kuka-kr16-l6/Motion-control-solutions-for-an-industrial-manipulator/GUI/UntitledProject1Content/images/images3.jpg

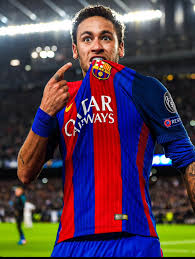
GUI/UntitledProject1Content/images/images3.jpg
