kuka-kr16-l6/Motion-control-solutions-for-an-industrial-manipulator/GUI/UntitledProject1Content/images/images.jpg

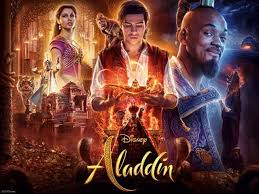
GUI/UntitledProject1Content/images/images.jpg
