kuka-kr16-l6/Motion-control-solutions-for-an-industrial-manipulator/hardware/control_cabinet/Kuka Robot Arm Panel.edb/Images/bc146770/EPLAN.jpg

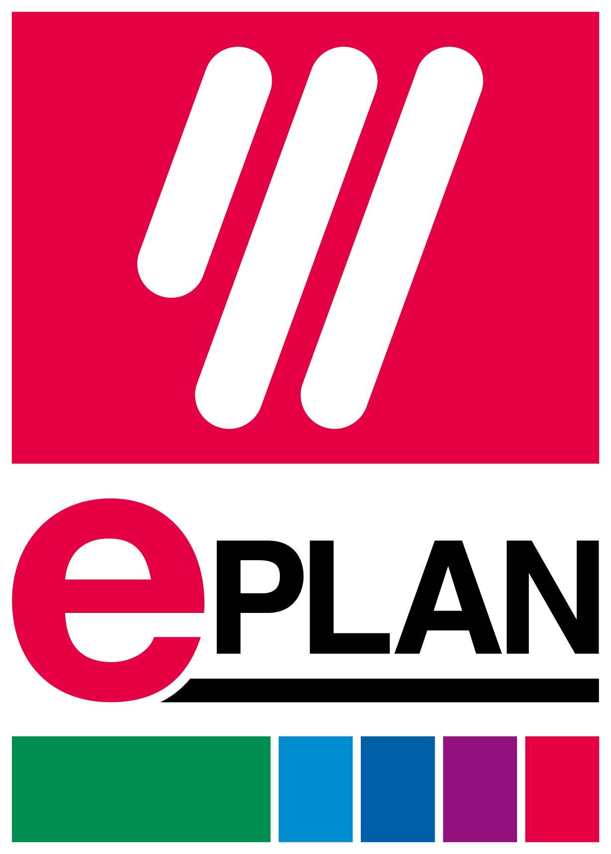
hardware/control_cabinet/Kuka Robot Arm Panel.edb/Images/bc146770/EPLAN.jpg
