kuka-kr16-l6/Motion-control-solutions-for-an-industrial-manipulator/hardware/control_cabinet/Kuka Robot Arm Panel.edb/Images/M54d7e7ba/WhatsApp Image 2026-07-18 at 9.05.26 AM.jpeg

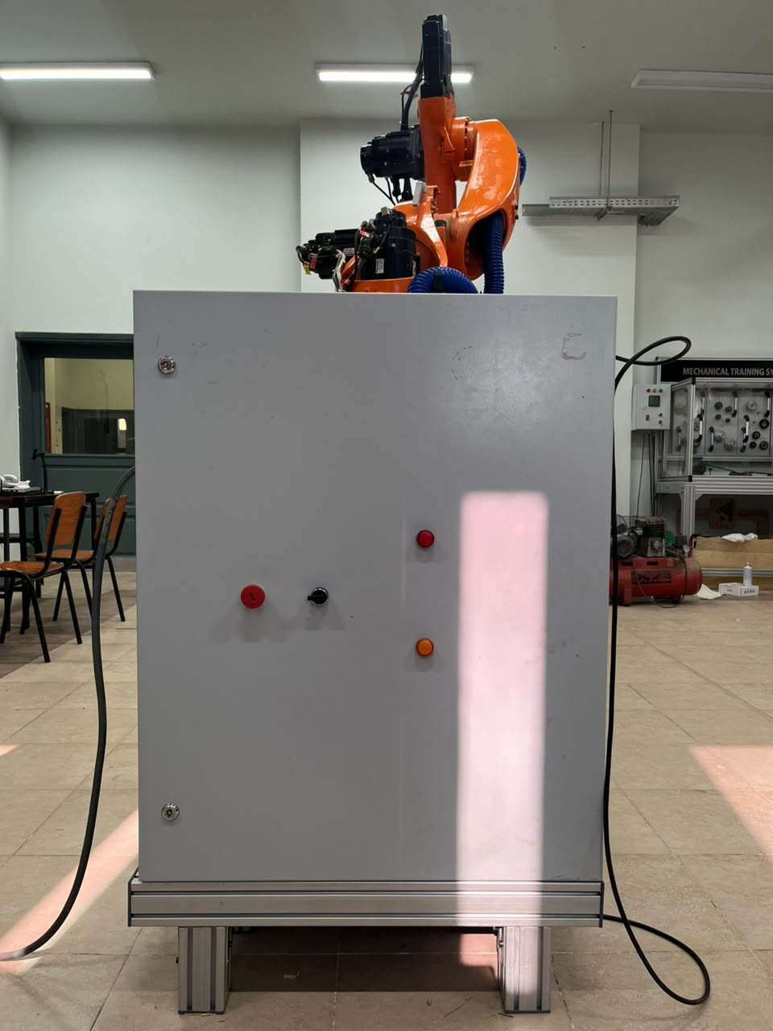
hardware/control_cabinet/Kuka Robot Arm Panel.edb/Images/M54d7e7ba/WhatsApp Image 2026-07-18 at 9.05.26 AM.jpeg
