kuka-kr16-l6/Motion-control-solutions-for-an-industrial-manipulator/hardware/control_cabinet/Kuka Robot Arm Panel.edb/Images/M33027262/WhatsApp Image 2026-08-03 at 3.58.57 PM (1).jpeg

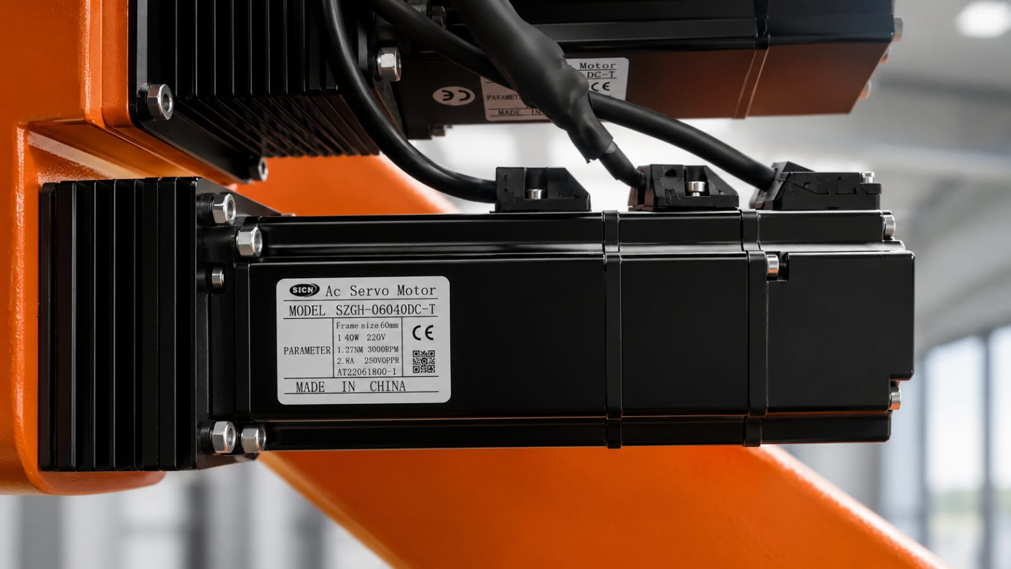
hardware/control_cabinet/Kuka Robot Arm Panel.edb/Images/M33027262/WhatsApp Image 2026-08-03 at 3.58.57 PM (1).jpeg
