kuka-kr16-l6/Motion-control-solutions-for-an-industrial-manipulator/hardware/mechanical/solidworks_assembly/kr16_l6/KR16-AV300.sldasm-Part-1-1.SLDPRT

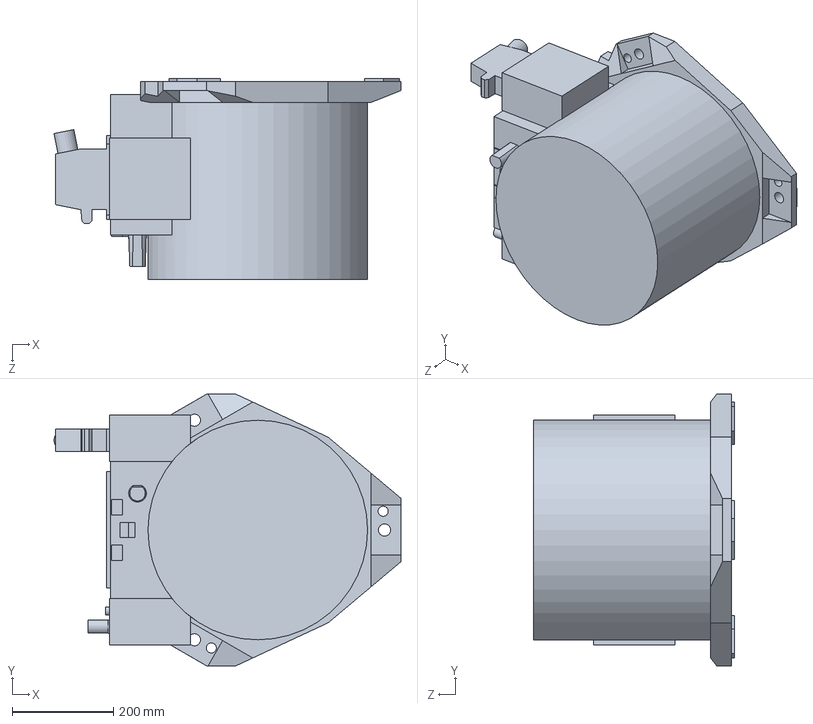
[picture p20: CAD file, 2026-01-29]
hardware/mechanical/solidworks_assembly/kr16_l6/KR16-AV300.sldasm-Part-1-1.SLDPRT
684.3 x 536.0 x 396.9 mm
