kuka-kr16-l6/Motion-control-solutions-for-an-industrial-manipulator/hardware/mechanical/solidworks_assembly/kr16_l6/KR16-AV300.sldasm-Part-16.SLDPRT

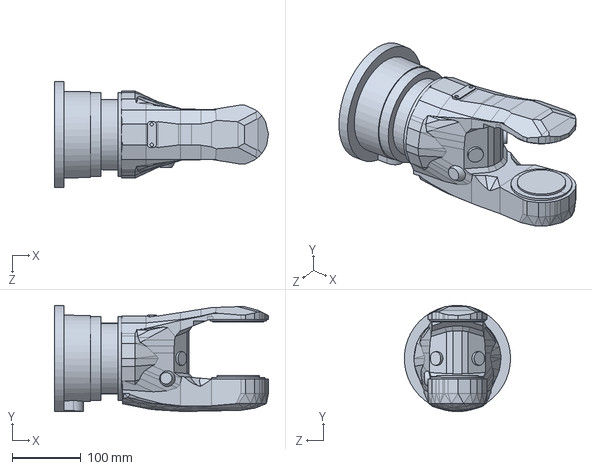
[picture p21: CAD file, 2026-01-29]
hardware/mechanical/solidworks_assembly/kr16_l6/KR16-AV300.sldasm-Part-16.SLDPRT
312.2 x 155.0 x 154.8 mm
