kuka-kr16-l6/Motion-control-solutions-for-an-industrial-manipulator/hardware/mechanical/solidworks_assembly/kr16_l6/KR16-AV300.sldasm-Part-7.SLDPRT

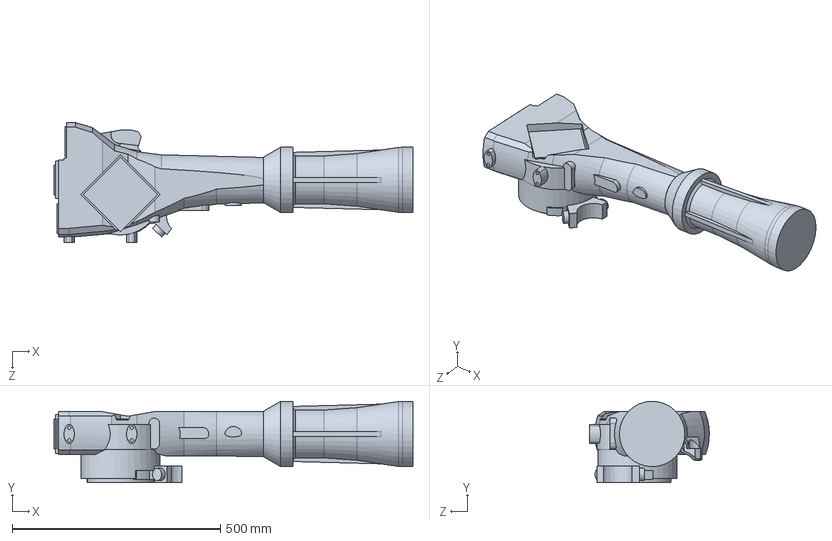
[picture p22: CAD file, 2026-01-29]
hardware/mechanical/solidworks_assembly/kr16_l6/KR16-AV300.sldasm-Part-7.SLDPRT
861.5 x 195.5 x 287.5 mm
