kuka-kr16-l6/Motion-control-solutions-for-an-industrial-manipulator/hardware/mechanical/solidworks_assembly/kr16_l6/KR16-AV300.sldasm-Part-15.SLDPRT

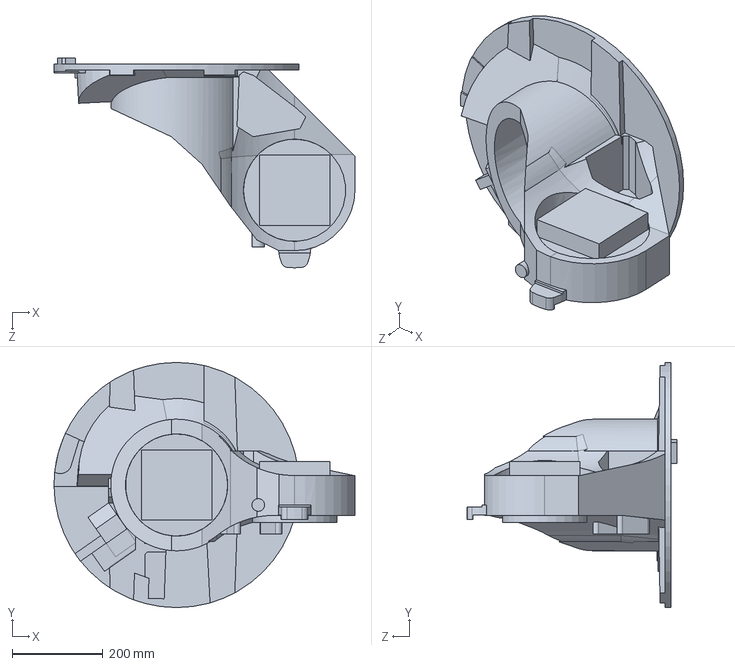
[picture p23: CAD file, 2026-01-29]
hardware/mechanical/solidworks_assembly/kr16_l6/KR16-AV300.sldasm-Part-15.SLDPRT
663.0 x 540.0 x 461.9 mm
