kuka-kr16-l6/Motion-control-solutions-for-an-industrial-manipulator/hardware/mechanical/solidworks_assembly/kr16_l6/KR16-AV300.sldasm-Part-14.SLDPRT

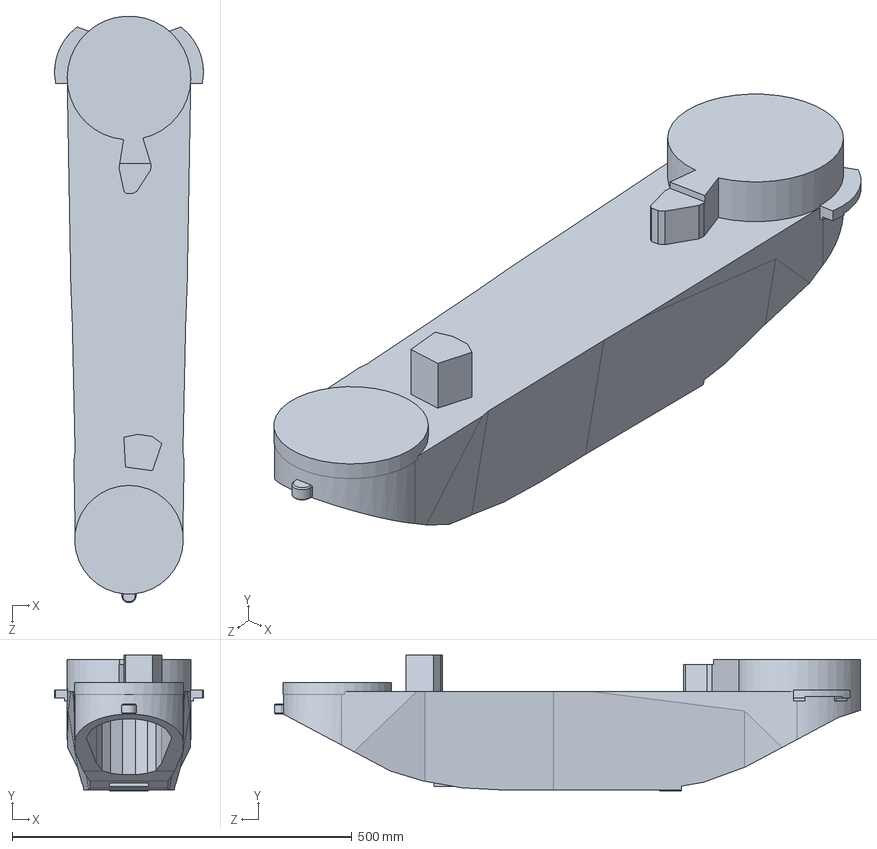
[picture p24: CAD file, 2026-01-29]
hardware/mechanical/solidworks_assembly/kr16_l6/KR16-AV300.sldasm-Part-14.SLDPRT
219.4 x 199.5 x 863.5 mm
