kuka-kr16-l6/Motion-control-solutions-for-an-industrial-manipulator/simulation_pkg/kr16_l6/meshes/collision/link_3.STL

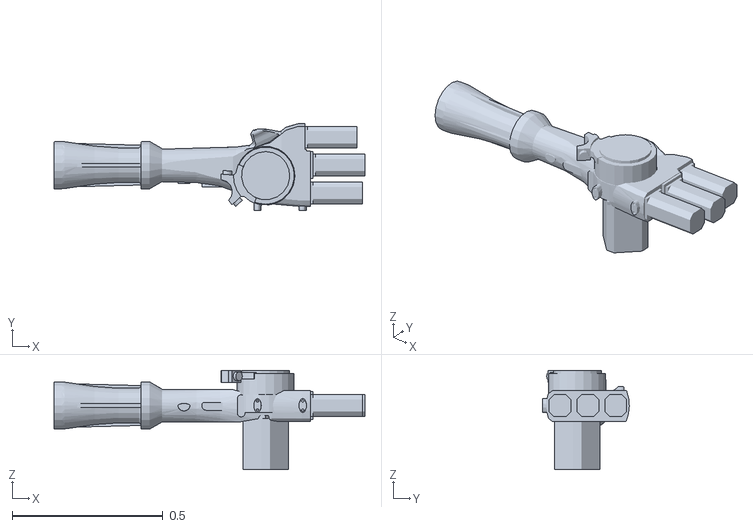
[picture p25: CAD file, 2026-01-29]
simulation_pkg/kr16_l6/meshes/collision/link_3.STL
1.03 x 0.287 x 0.33
