kuka-kr16-l6/Motion-control-solutions-for-an-industrial-manipulator/simulation_pkg/kr16_l6/meshes/visual/link_4.STL

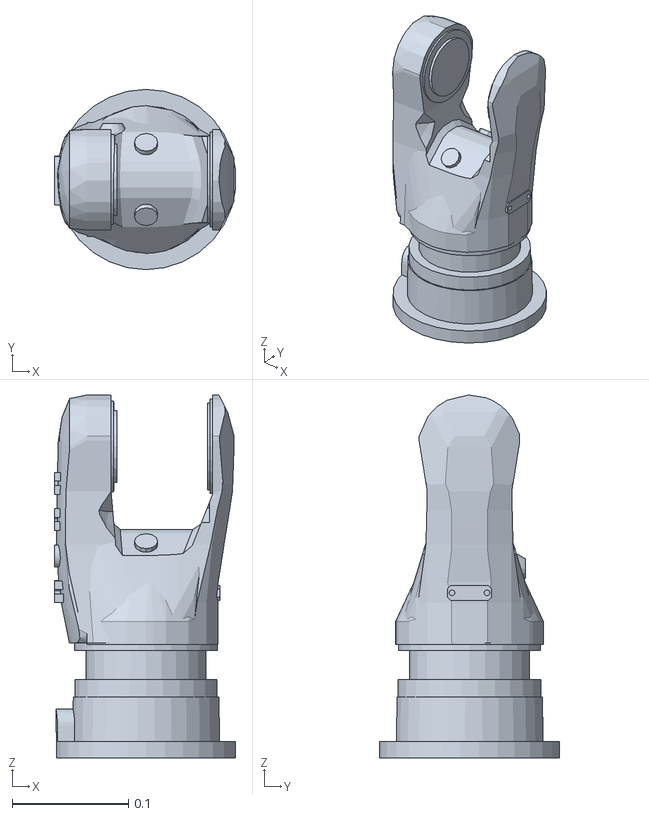
[picture p26: CAD file, 2026-01-29]
simulation_pkg/kr16_l6/meshes/visual/link_4.STL
0.156 x 0.155 x 0.312
