kuka-kr16-l6/Motion-control-solutions-for-an-industrial-manipulator/simulation_pkg/kr16_l6/meshes/collision/link_6.STL

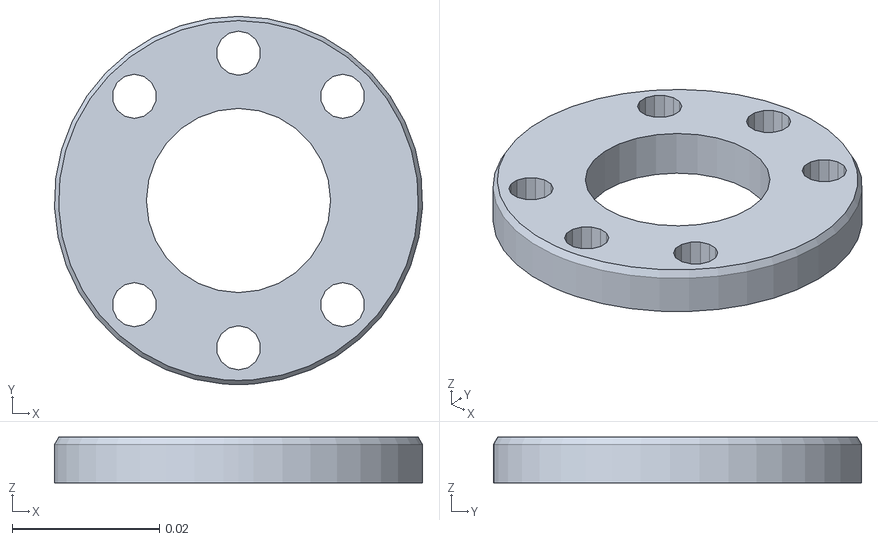
[picture p27: CAD file, 2026-01-29]
simulation_pkg/kr16_l6/meshes/collision/link_6.STL
0.05 x 0.05 x 0.0062
