kuka-kr16-l6/Motion-control-solutions-for-an-industrial-manipulator/simulation_pkg/kr16_l6/meshes/collision/link_2.STL

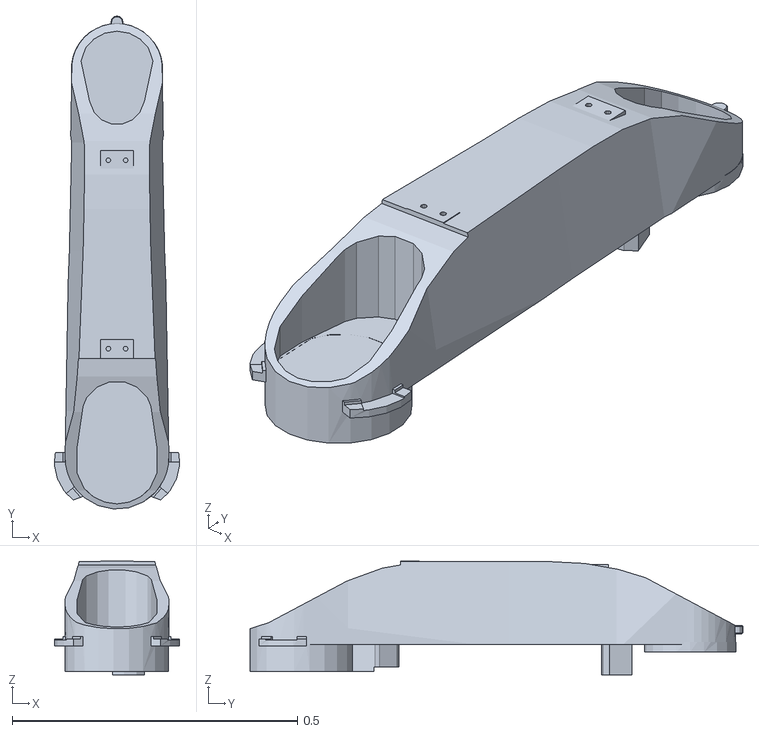
[picture p28: CAD file, 2026-01-29]
simulation_pkg/kr16_l6/meshes/collision/link_2.STL
0.219 x 0.863 x 0.199
