kuka-kr16-l6/Motion-control-solutions-for-an-industrial-manipulator/simulation_pkg/kr16_l6/meshes/visual/base_link.STL

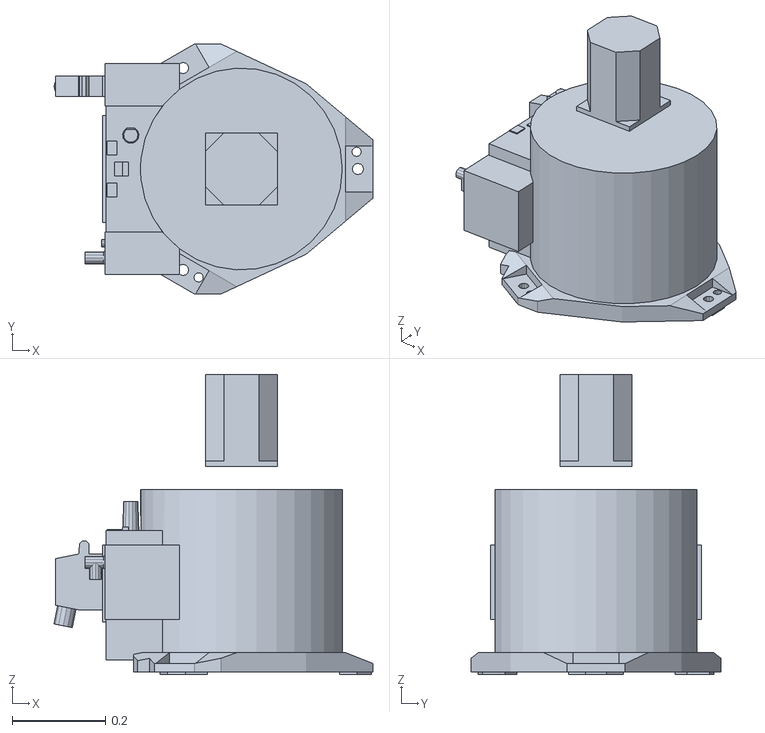
[picture p29: CAD file, 2026-01-29]
simulation_pkg/kr16_l6/meshes/visual/base_link.STL
0.684 x 0.536 x 0.644
