kuka-kr16-l6/Motion-control-solutions-for-an-industrial-manipulator/simulation_pkg/kr16_l6/meshes/visual/link_1.STL

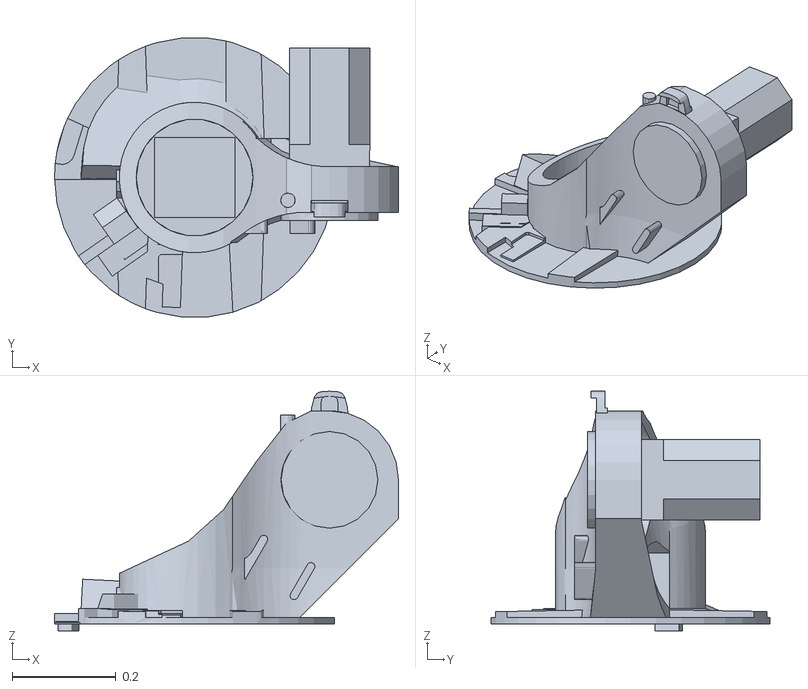
[picture p30: CAD file, 2026-01-29]
simulation_pkg/kr16_l6/meshes/visual/link_1.STL
0.663 x 0.538 x 0.462
