kuka-kr16-l6/Motion-control-solutions-for-an-industrial-manipulator/simulation_pkg/kr16_l6/meshes/collision/link_5.STL

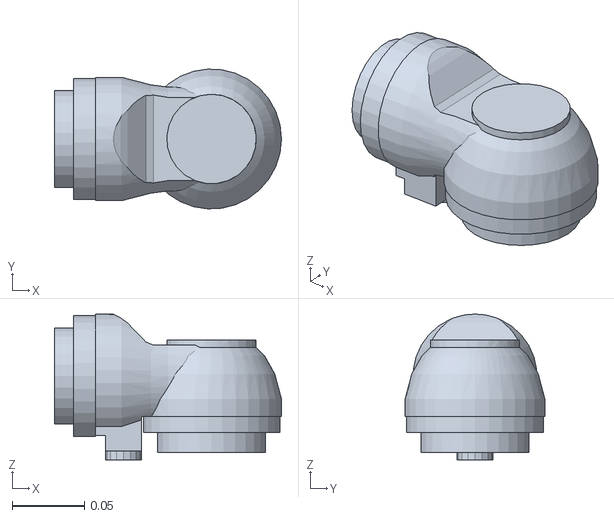
[picture p31: CAD file, 2026-01-29]
simulation_pkg/kr16_l6/meshes/collision/link_5.STL
0.157 x 0.0969 x 0.101
