kuka-kr16-l6/Motion-control-solutions-for-an-industrial-manipulator/hardware/mechanical/solidworks_assembly/kr16_l6/KR16.SLDASM

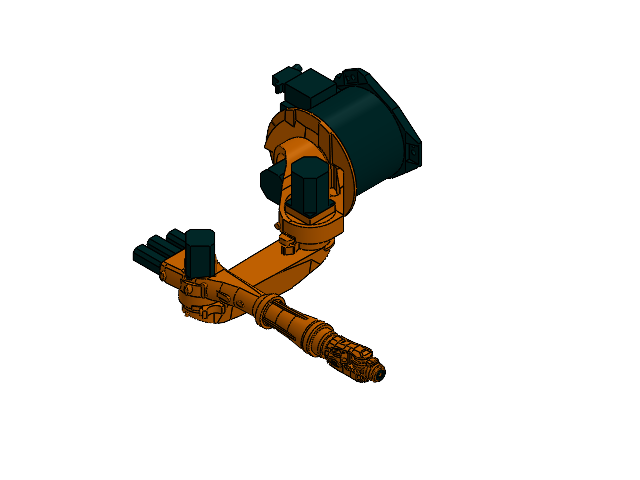
[picture p32: CAD file, 2026-01-29]
hardware/mechanical/solidworks_assembly/kr16_l6/KR16.SLDASM
KR16-AV300.sldasm-Part-1-1
KR16-AV300.sldasm-Part-2-1
KR16-AV300.sldasm-Part-3-1
KR16-AV300.sldasm-Part-4-1
KR16-AV300.sldasm-Part-5-1
KR16-AV300.sldasm-Part-6-1
KR16-AV300.sldasm-Part-7-1
KR16-AV300.sldasm-Part-8-1
KR16-AV300.sldasm-Part-9-1
KR16-AV300.sldasm-Part-10-1
KR16-AV300.sldasm-Part-11-1
KR16-AV300.sldasm-Part-12-1
KR16-AV300.sldasm-Part-13-1
KR16-AV300.sldasm-Part-14-1
KR16-AV300.sldasm-Part-15-1
KR16-AV300.sldasm-Part-16-1
KR16-AV300.sldasm-Part-17-1
