kuka-kr16-l6/Motion-control-solutions-for-an-industrial-manipulator/data/wiring&schematics.pdf

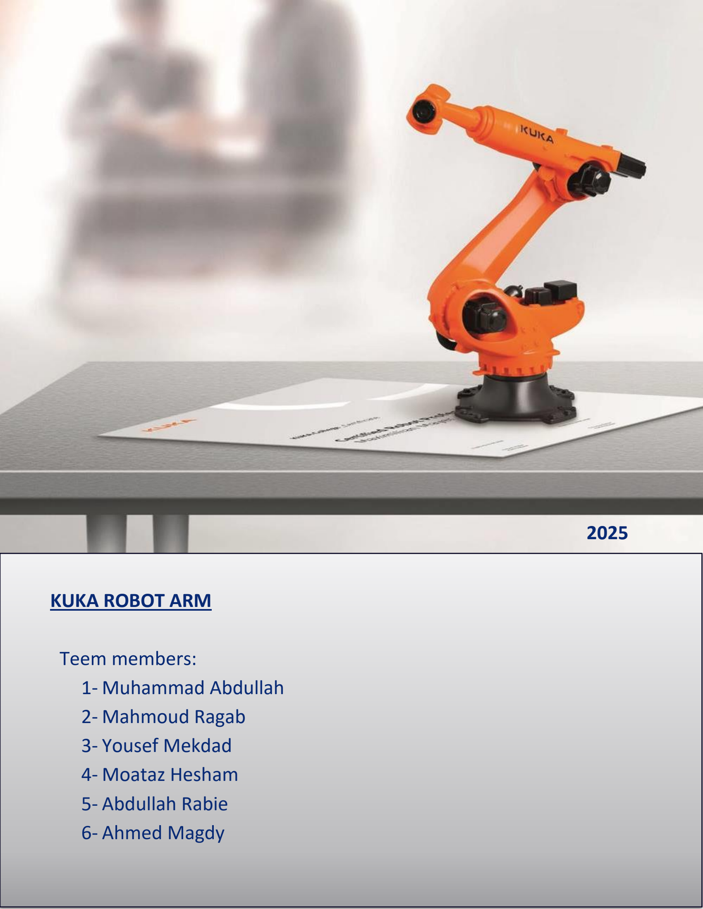
[picture p33: page 1]

1

KUKA ROBOT ARM

Teem members:
1- Muhammad Abdullah
2- Mahmoud Ragab
3- Yousef Mekdad
4- Moataz Hesham
5- Abdullah Rabie
6- Ahmed Magdy

2025

2

## ❖ Robot arm:

## ❖ Motors:

A1:

A2:

A3:

A4:

A5:

A6:

## ❖ Drivers:

A1:

A2:

A3:

A4:

A5:

A6:

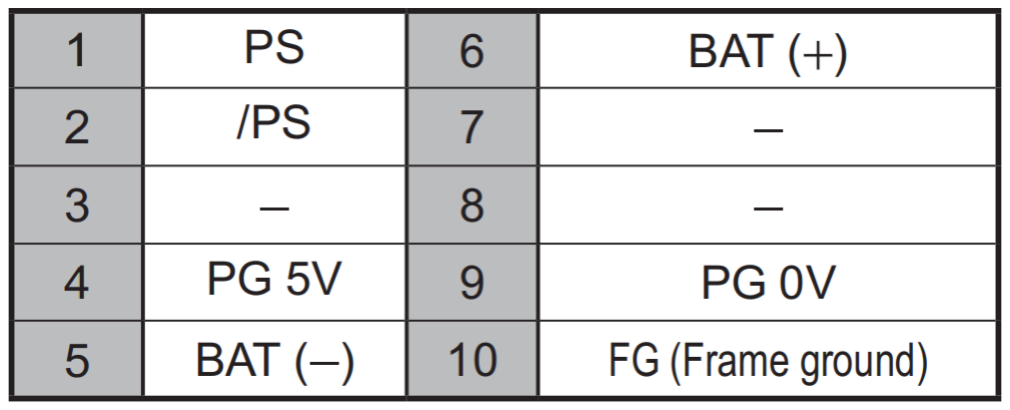
[picture p34: figure]
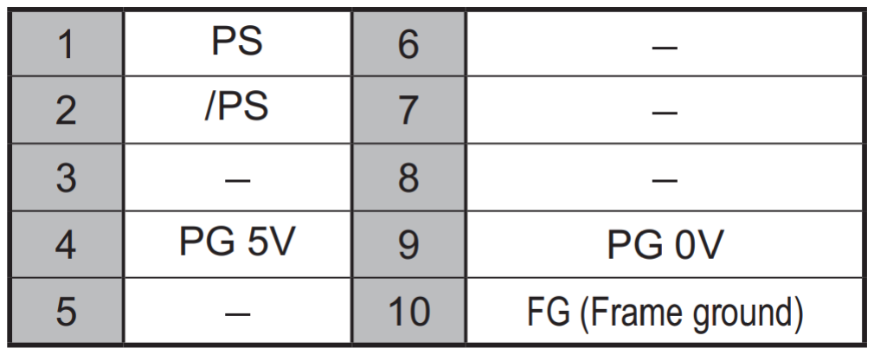
[picture p35: figure]

3

## - Motors wiring:

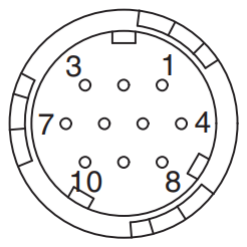
[picture p36: figure]

1-Cable Specifications for Encoder end Connector (20-bit Encoder):

- Receptacle: CM10-R10P-D.
- Plug: CM10-AP10S-¡-D (Angle) CM10SP10S-¡-D (Straight).
- Manufacturer: DDK Ltd.
- With an Absolute Encoder:
- With an Incremental Encoder:

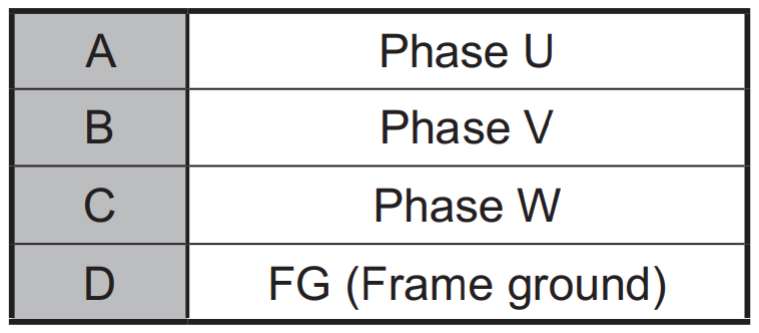
[picture p37: figure]
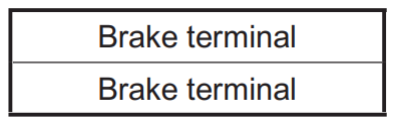
[picture p38: figure]

4

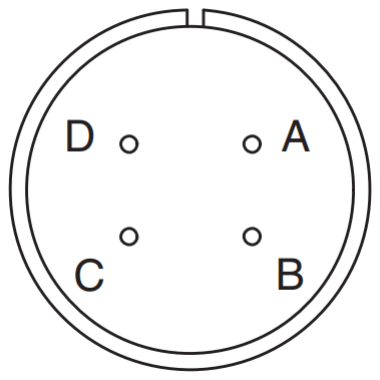
[picture p39: figure]

2- Cable Specifications for Servomotor-end Connector:

3- Cable Specifications for Brake-end Connector:

- Receptacle: CM10-R2P-D.
- Plug: CM10-AP2S-¡-D (Angle)
CM10-SP2S-¡-D (Straight).
- Manufacturer: DDK Ltd.

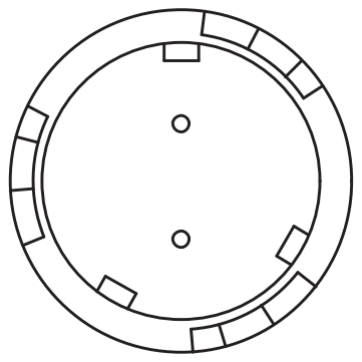
[picture p40: figure]

Note: No polarity for connection to the brake terminals.

Breaks work on 24V DC.

Make sure all shields are connected.

## - Control panel:

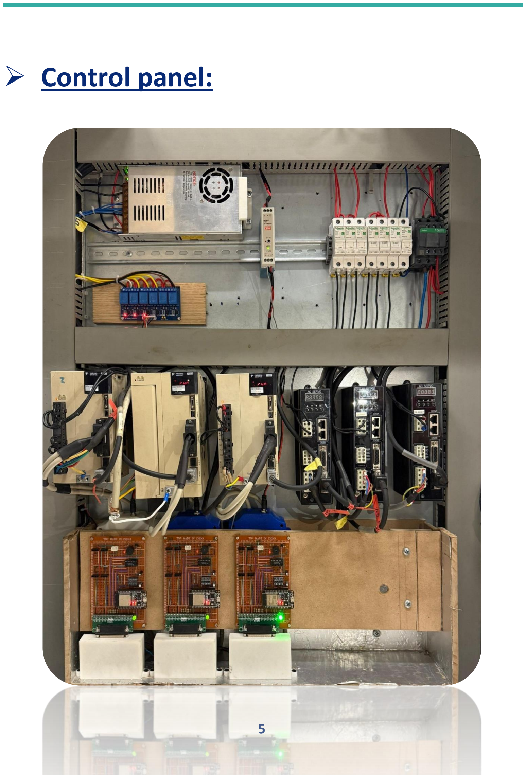
[picture p41: page 5]

5

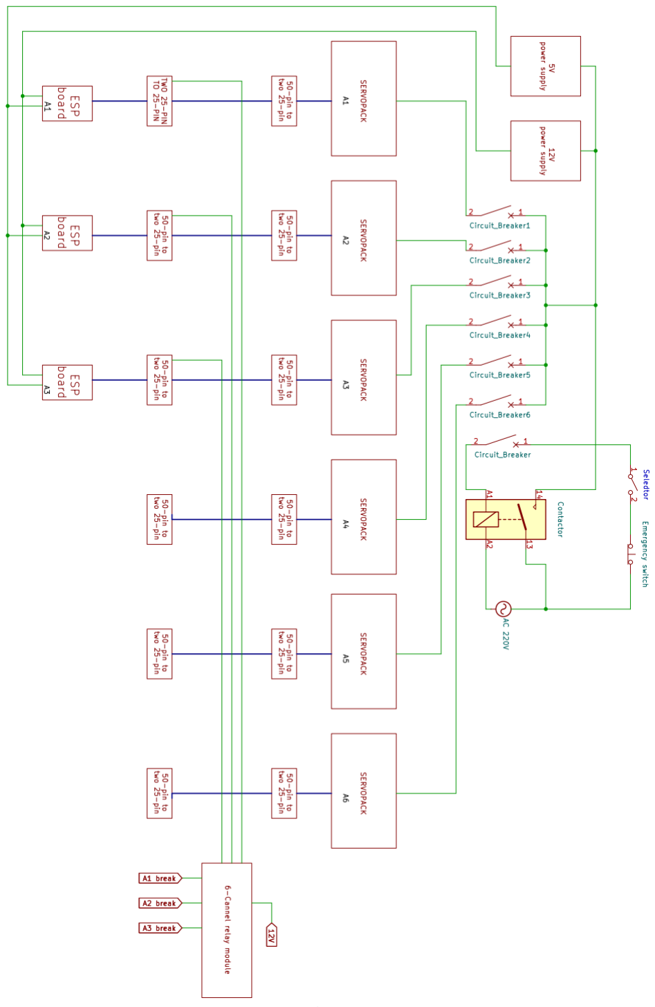
[picture p42: figure]

6

### - Panel schematic:

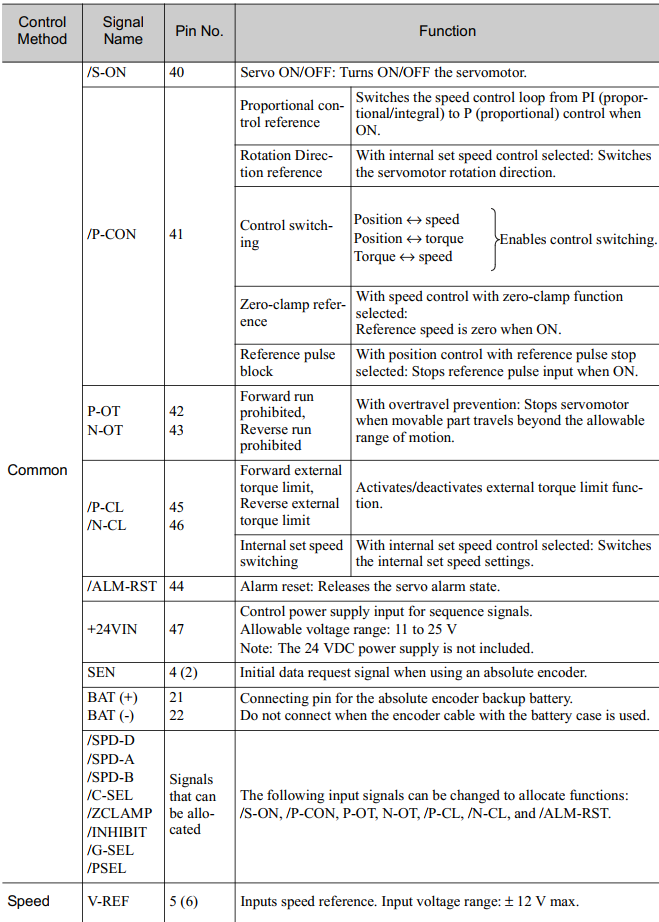
[picture p43: figure]

7

### Driver I/O Signal:

### 1-Input signals:

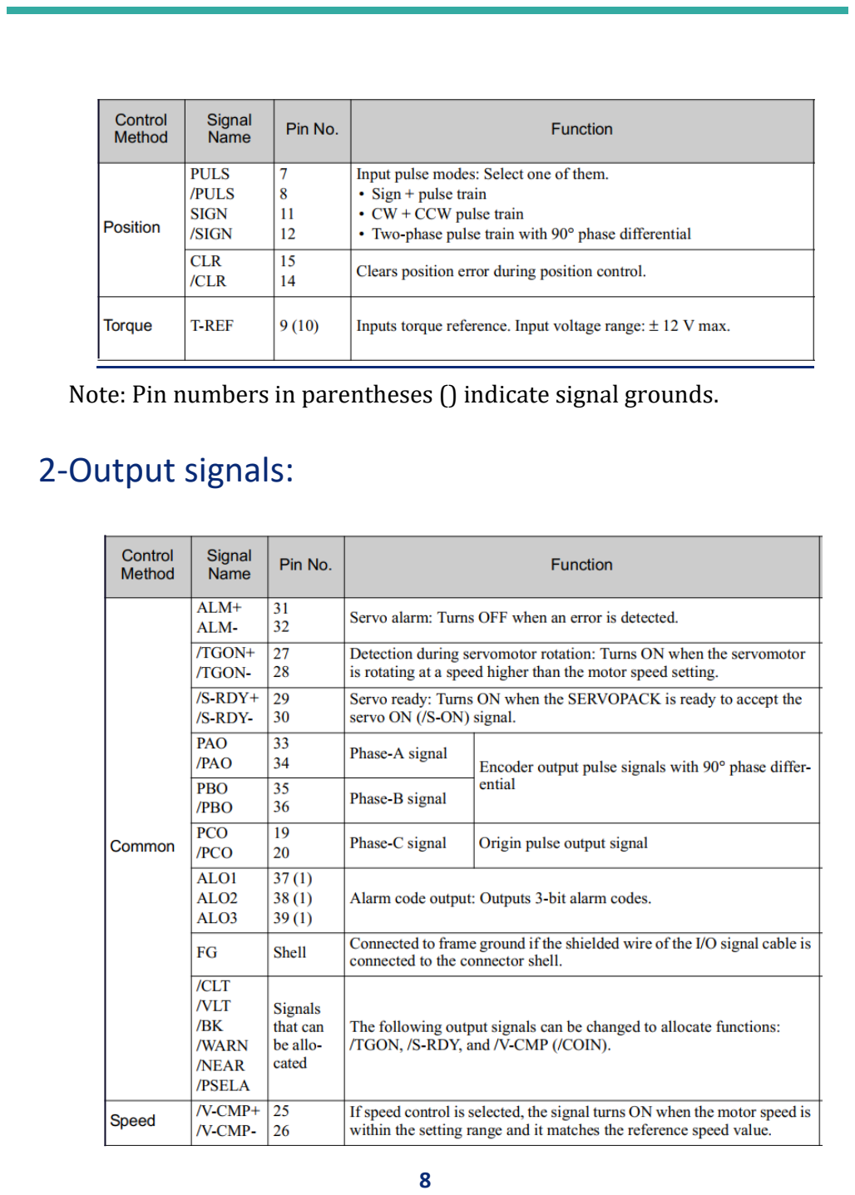
[picture p44: page 8]

8

Note: Pin numbers in parentheses () indicate signal grounds.

### 2-Output signals:

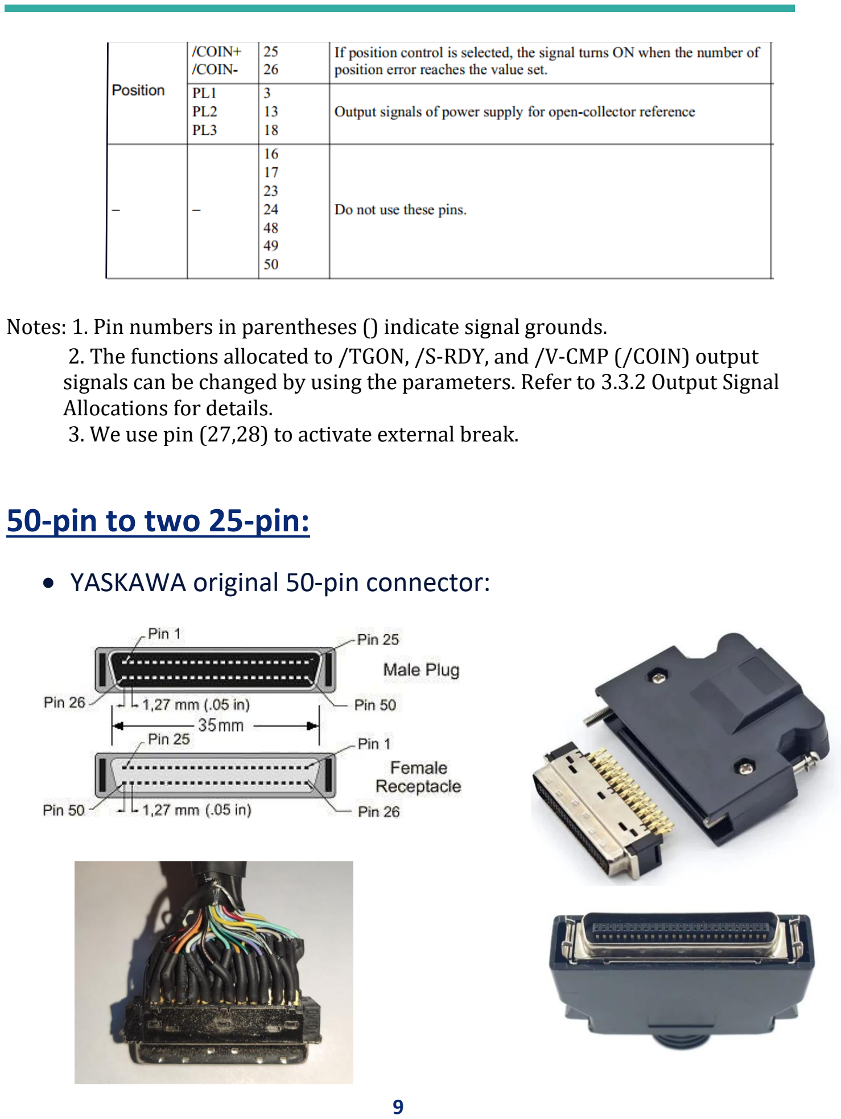
[picture p45: page 9]

9

Notes: 1. Pin numbers in parentheses () indicate signal grounds.
2. The functions allocated to /TGON, /S-RDY, and /V-CMP (/COIN) output signals can be changed by using the parameters. Refer to 3.3.2 Output Signal Allocations for details.
3. We use pin (27,28) to activate external break.

### 50-pin to two 25-pin:

- YASKAWA original 50-pin connector:

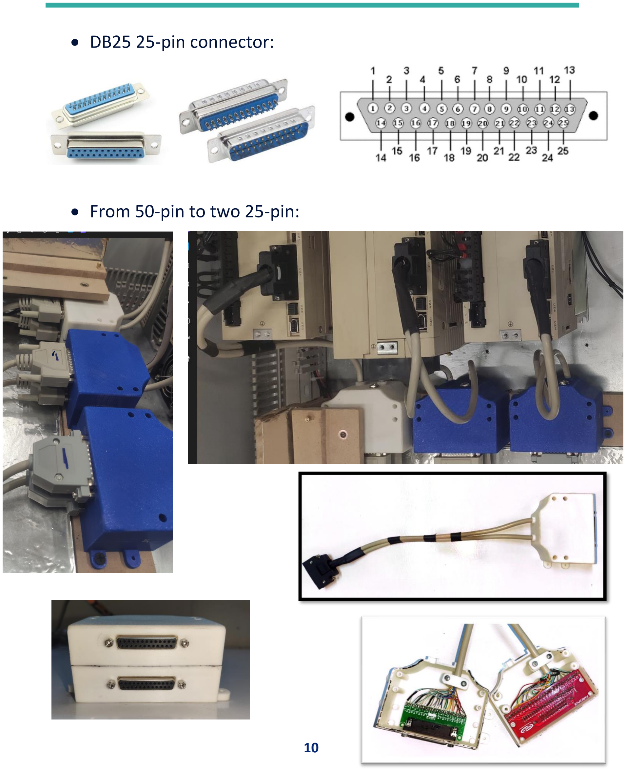
[picture p46: page 10]

10

- DB25 25-pin connector:
- From 50-pin to two 25-pin:

‘

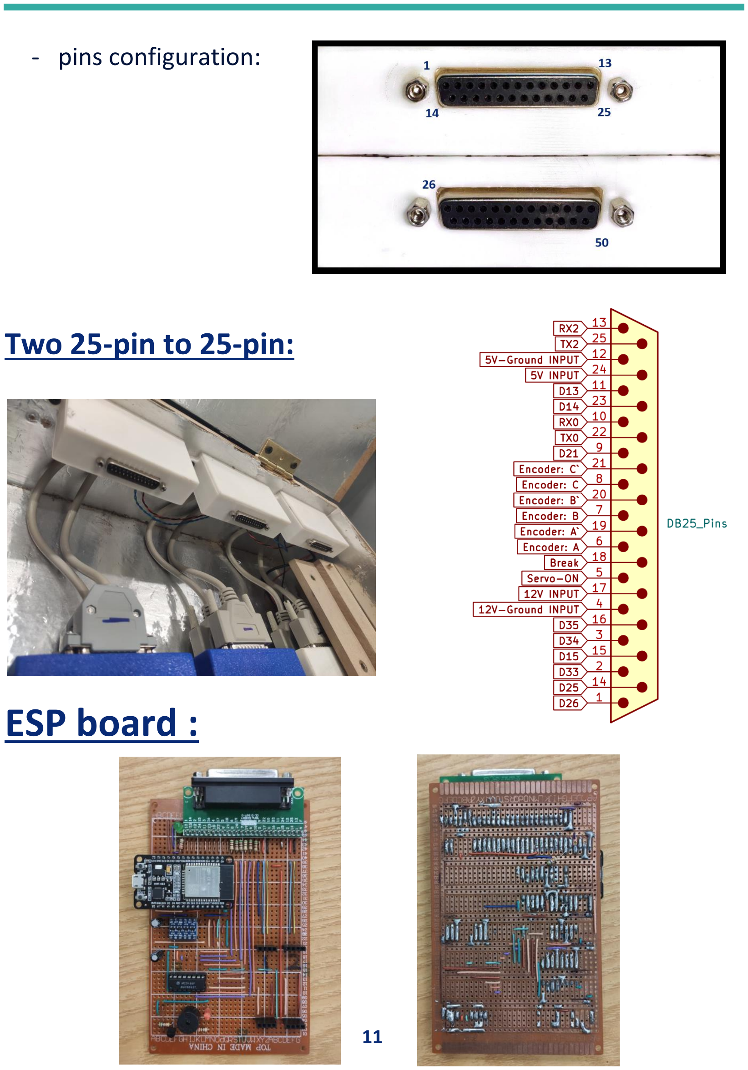
[picture p47: page 11]

11

- pins configuration:

### Two 25-pin to 25-pin:

## ESP board :

12

### I/O TABLE

ESP | DB25 connector | Function
13 | 11 (Directly connected to ESP) | Pulses
14 | 23 (Directly connected to ESP) | Sign
21 | 9 (Directly connected to ESP) | CLR
25 | 14 (Directly connected to ESP) | TRef
26 1 (Directly connected to ESP)
32 15 (Directly connected to ESP)
33 2 (Directly connected to ESP)
34 | 3 | Limit switch
35 | 16 | Limit switch
27 | 5 (servo-on) | Servo-on, Break-off (active
high) 18 (break)
19 (A) | 6 | Encoder: (Non-inverted_A)
| 19 Encoder: (Inverted_A)
18 (B) | 7 | Encoder: (Non-inverted_B)
| 20 Encoder: (Inverted_B)
4 (C) | 8 | Encoder: (Non-inverted_C)
| 21 Encoder: (Inverted_C)
23 Buzzer
RX2-TX2 | 13 RS-485 Transmitter (A)
| 25 RS-485 Transmitter (B)
RX0-TX0 | 10 RS-485 Receiver (A)
| 22 RS-485 Receiver (B)
| 24 5V INPUT
| 12 5V-Ground INPUT
| 17 12V INPUT
| 4 12V-Ground INPUT
| Shell | 5V-Ground

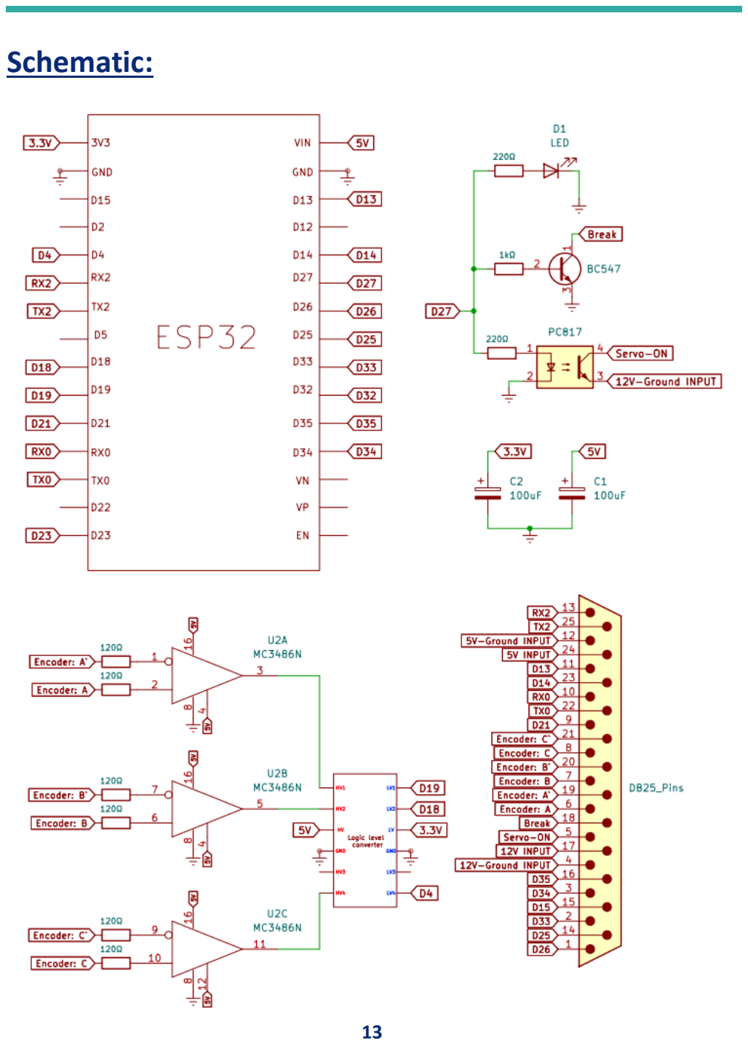
[picture p48: page 13]

13

### Schematic:

14
