kuka-kr16-l6/Motion-control-solutions-for-an-industrial-manipulator/hardware/control_cabinet/Eplan_Panel.pdf

## Faculty of Engineering

## Phone

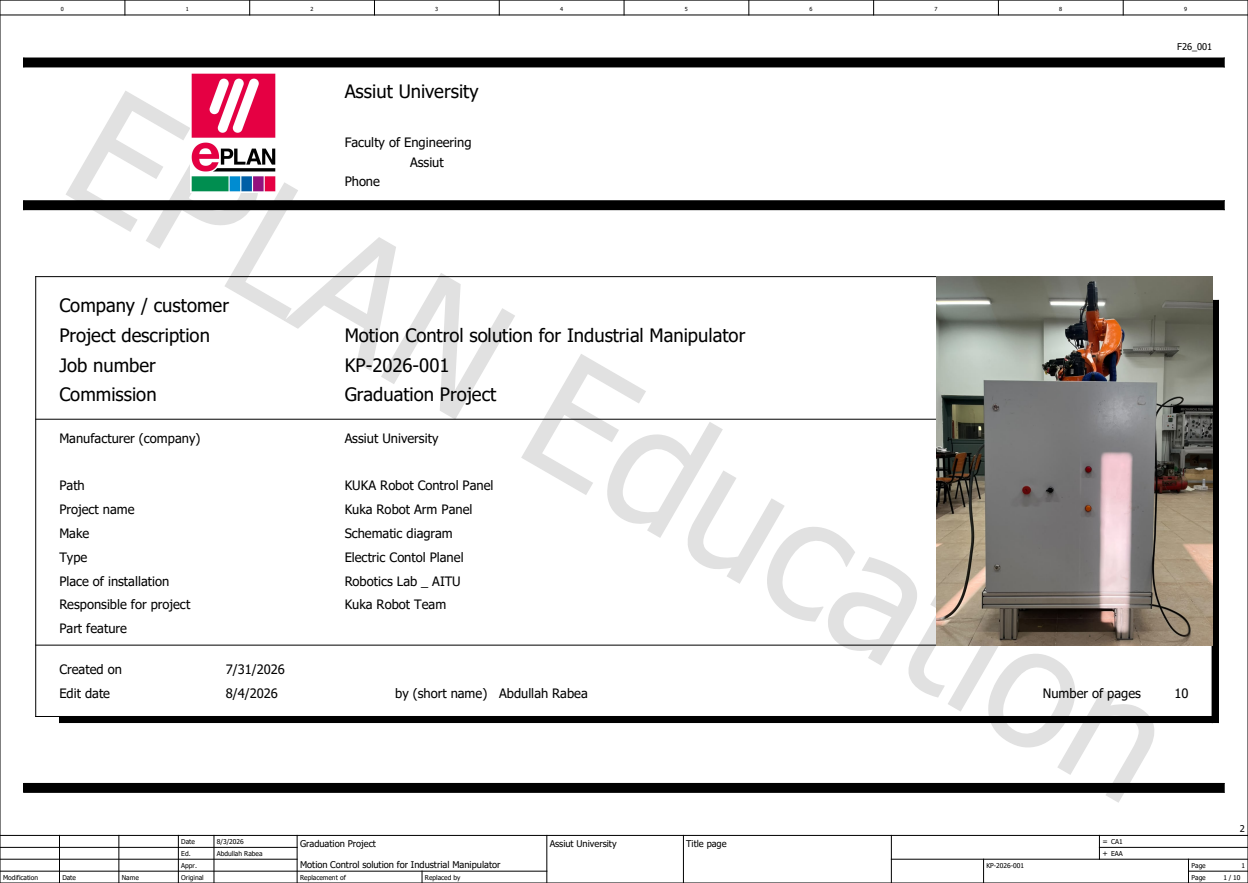
[picture p49: page 1]
Assiut University; Project description; Motion Control solution for Industrial Manipulator; Commission; Edit date; Created on; Job number; Abdullah Rabea; Manufacturer (company); Project name; Kuka Robot Arm Panel; Company / customer; Graduation Project; Assiut

Path
Make
Type
Place of installation
Responsible for project
Part feature

KUKA Robot Control Panel

Schematic diagram
Electric Contol Planel
Robotics Lab _ AITU
Kuka Robot Team

by (short name)

Number of pages

8/3/2026 | Graduation Project Motion Control solution for Industrial Manipulator | Assiut University | Title page | = CA1

Ed. | Abdullah Rabea | | | | + EAA
Appr. | | | | | KP-2026-001 | Page

Modification | Date | Name | Original | | Replacement of | Replaced by | | | | 1 / 10

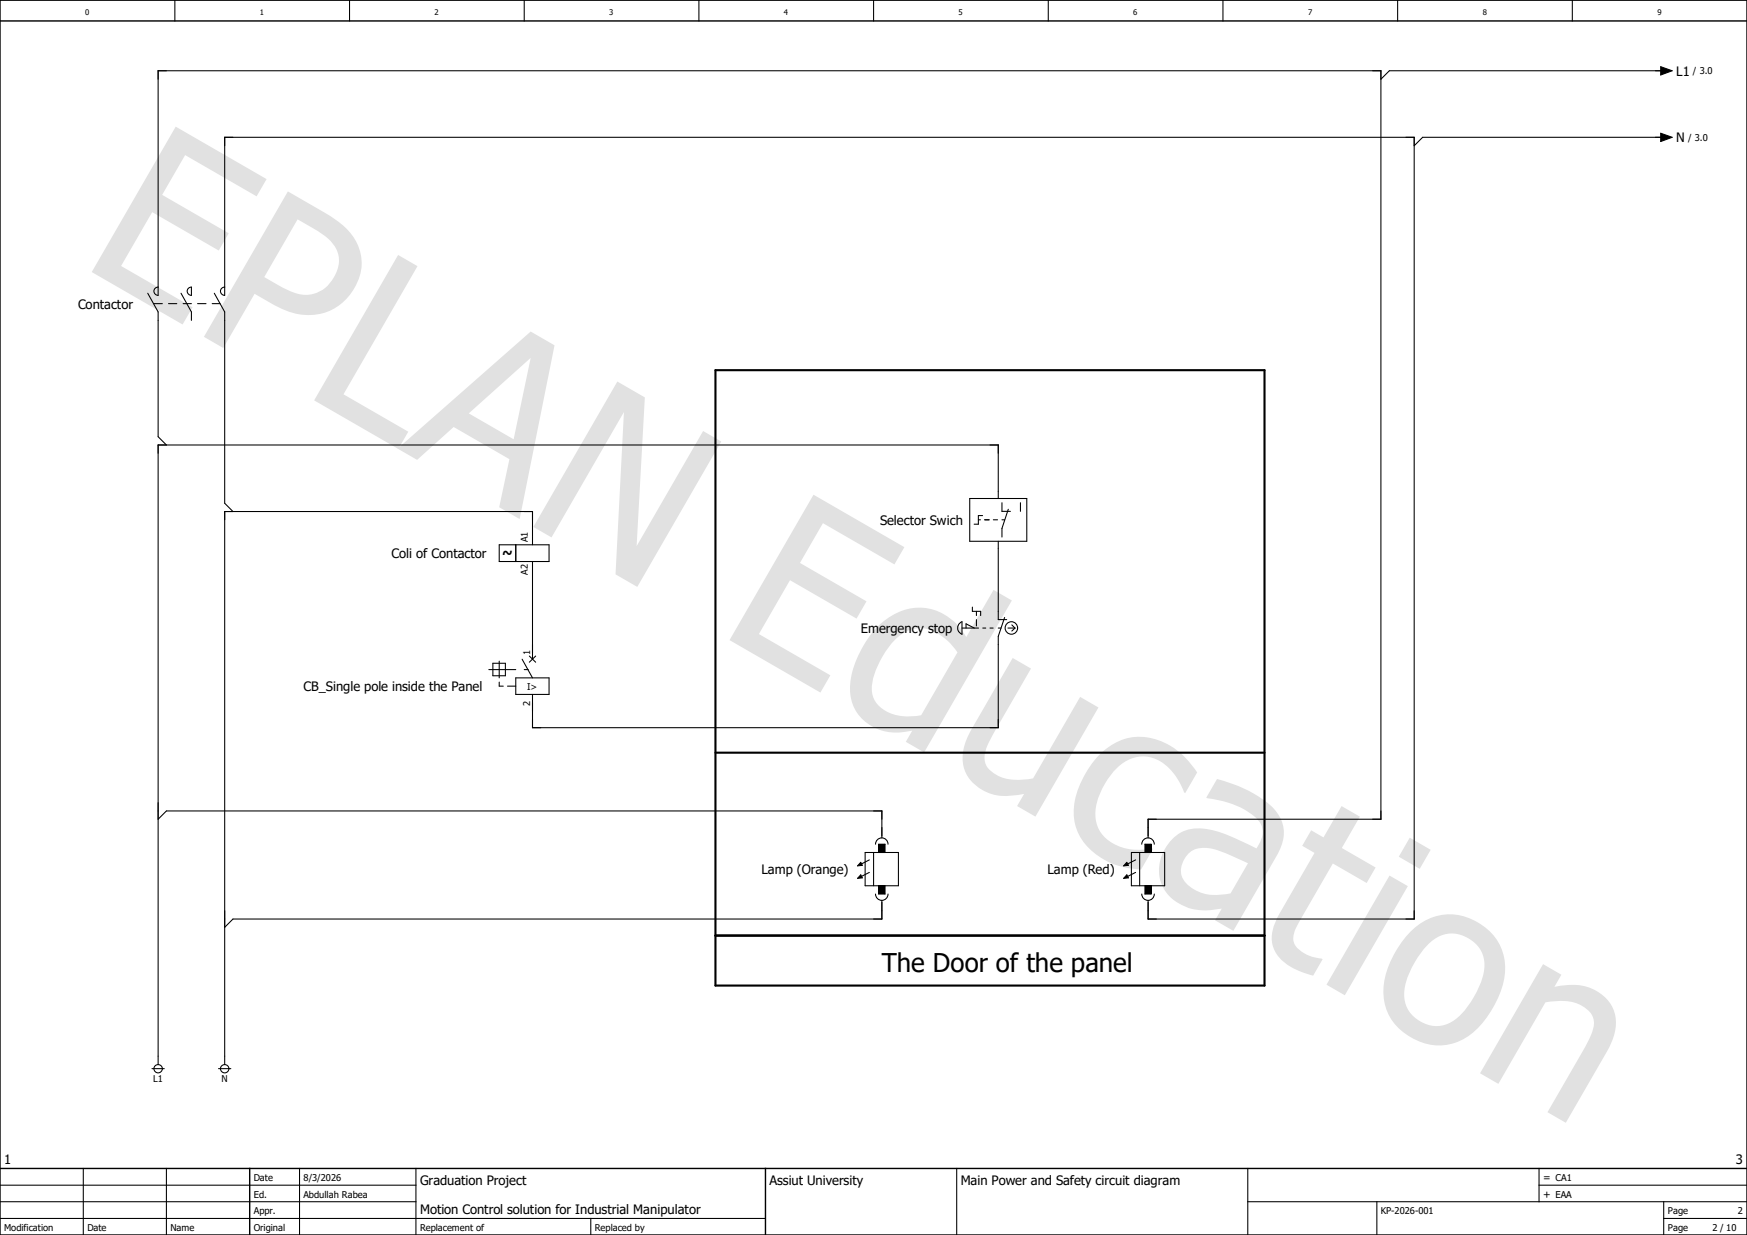
[picture p50: page 2]
Lamp (Orange); Contactor; CB_Single pole inside the Panel; Lamp (Red); Emergency stop; Coli of Contactor

Selector Swich A¹ A²

The Door of the panel

Main Power and Safety circuit diagram

L1

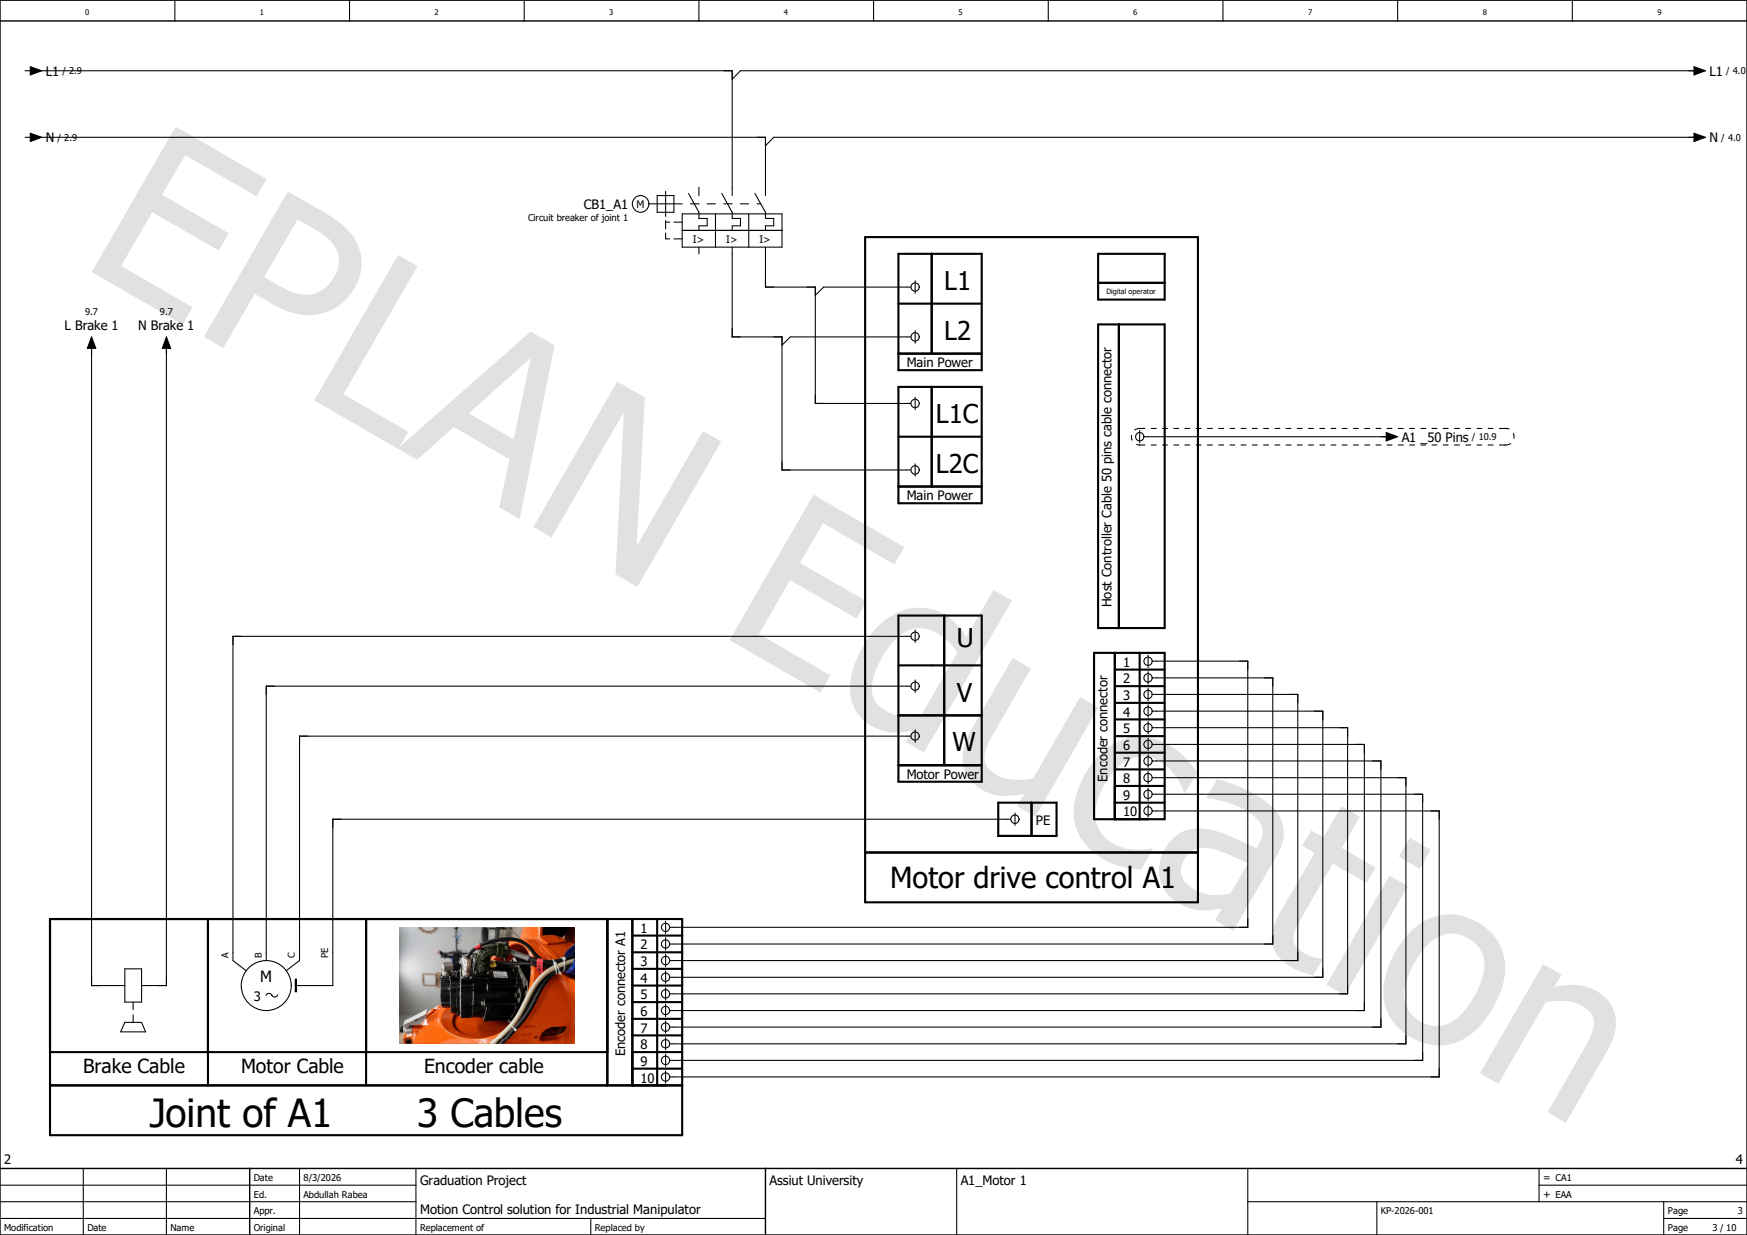
[picture p51: page 3]
A1_Motor 1; Main Power; Motor Power; Encoder connector Host Controller Cable 50 pins cable connector; Joint of A1; 3 Cables; 10 Encoder connector A¹; Digital operator; BCPE M; L Brake 1; N Brake 1; A1 _50 Pins / 10.9

Circuit breaker of joint 1

L1C
L2C

Motor drive control A1

Brake Cable | Motor Cable | Encoder cable | 9

L1

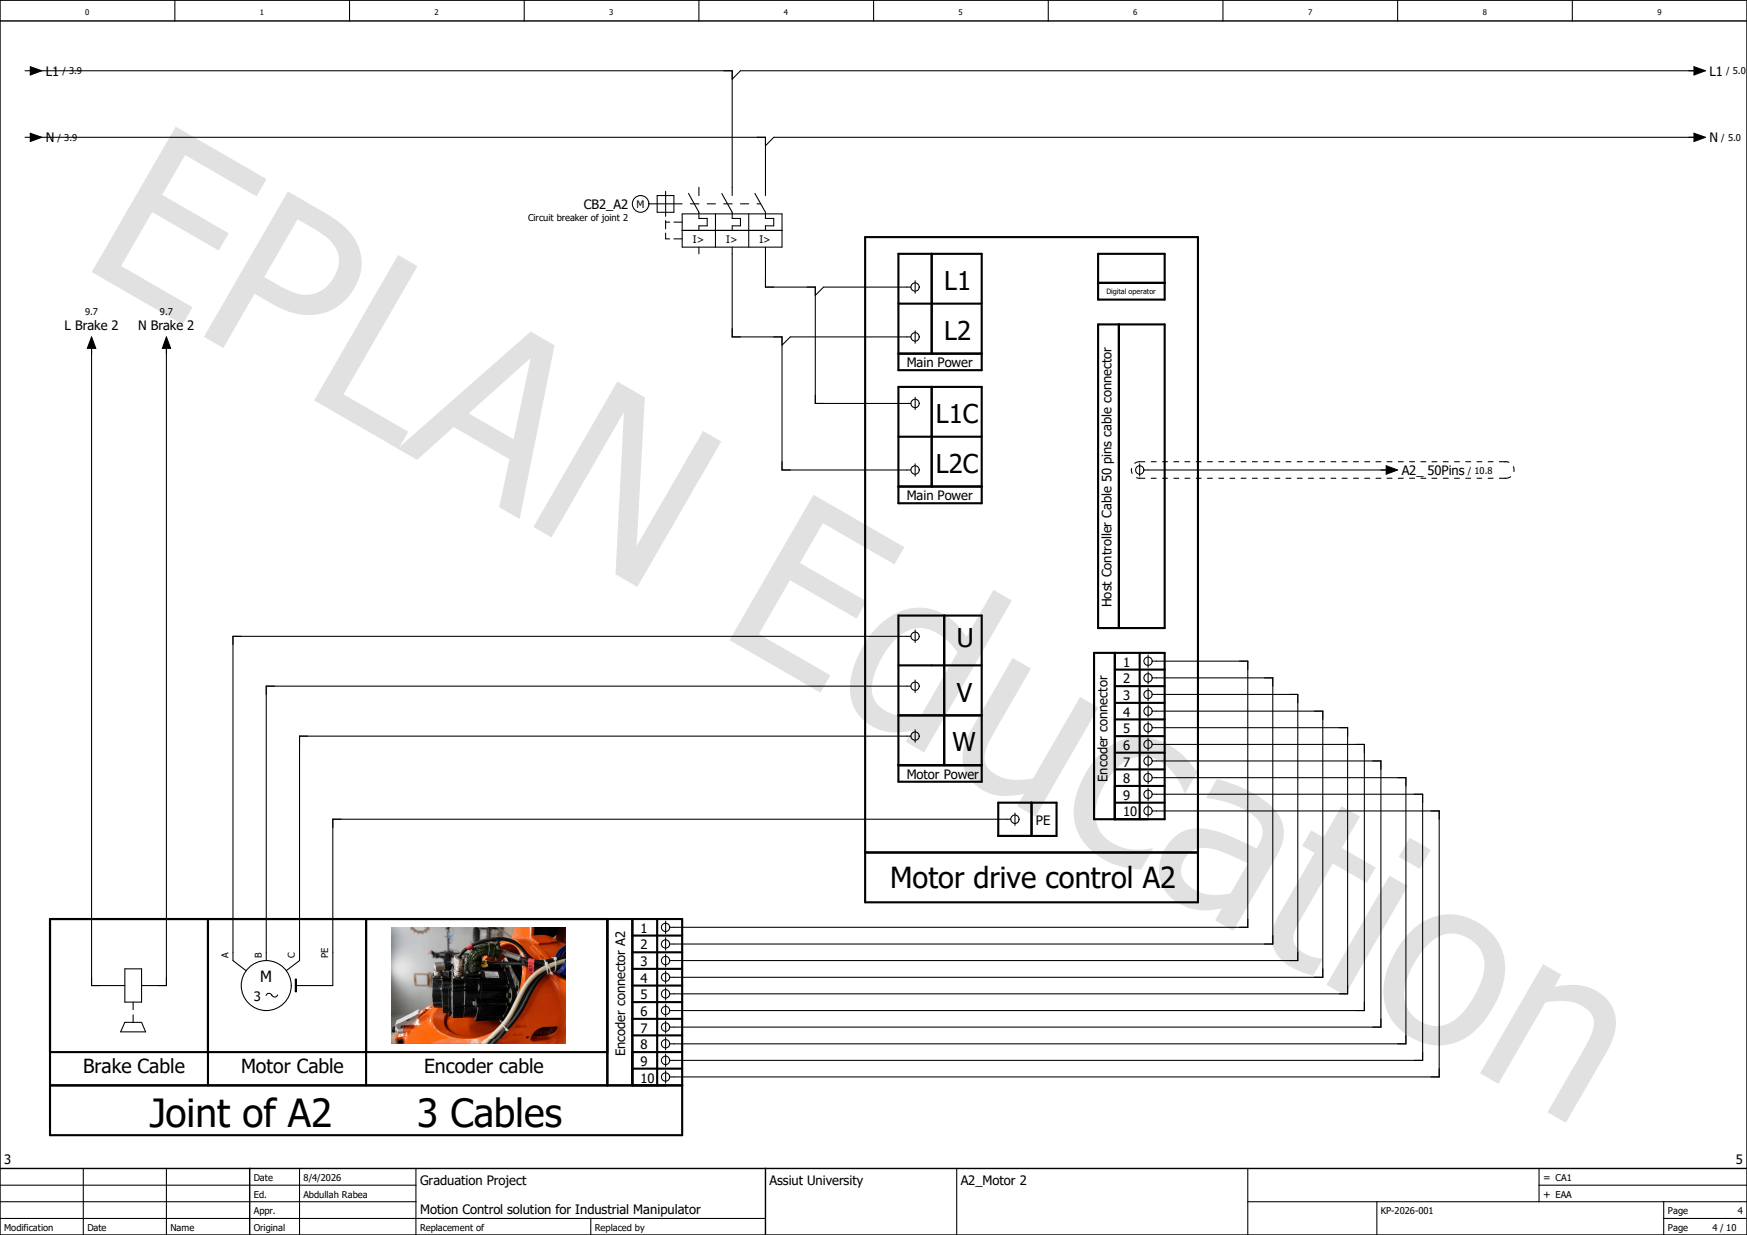
[picture p52: page 4]
A2_Motor 2; Assiut University; Main Power; Motor Power; Encoder connector Host Controller Cable 50 pins cable connector; Joint of A2; 3 Cables; 10 Encoder connector A²; Digital operator; BCPE M; L Brake 2; N Brake 2; A2_ 50Pins / 10.8

Circuit breaker of joint 2

L1C
L2C

Motor drive control A2

Brake Cable | Motor Cable | Encoder cable | 9

L1

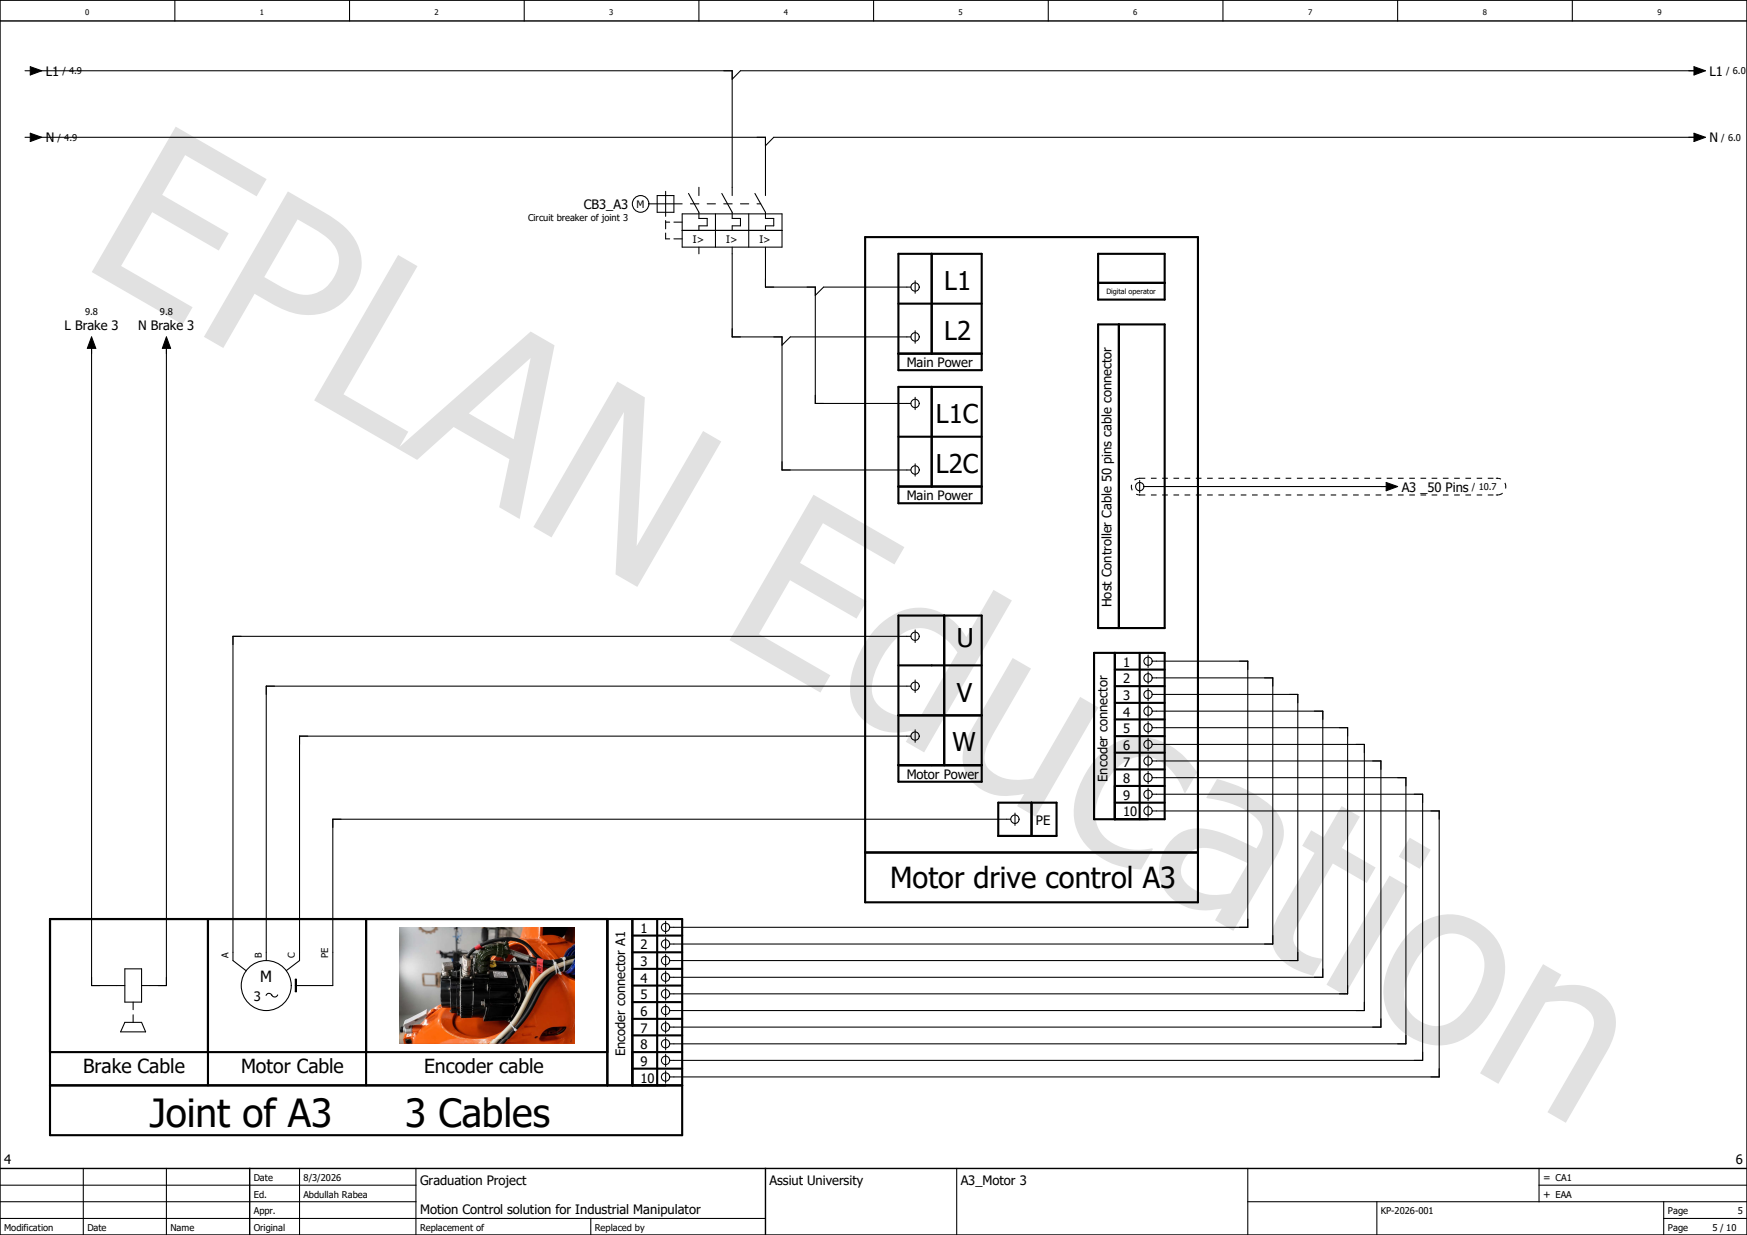
[picture p53: page 5]
A3_Motor 3; Main Power; Motor Power; Encoder connector Host Controller Cable 50 pins cable connector; Joint of A3; 3 Cables; 10 Encoder connector A¹; Digital operator; BCPE M; L Brake 3; N Brake 3; A3 _50 Pins / 10.7

Circuit breaker of joint 3

L1C
L2C

Motor drive control A3

Brake Cable | Motor Cable | Encoder cable | 9

L1

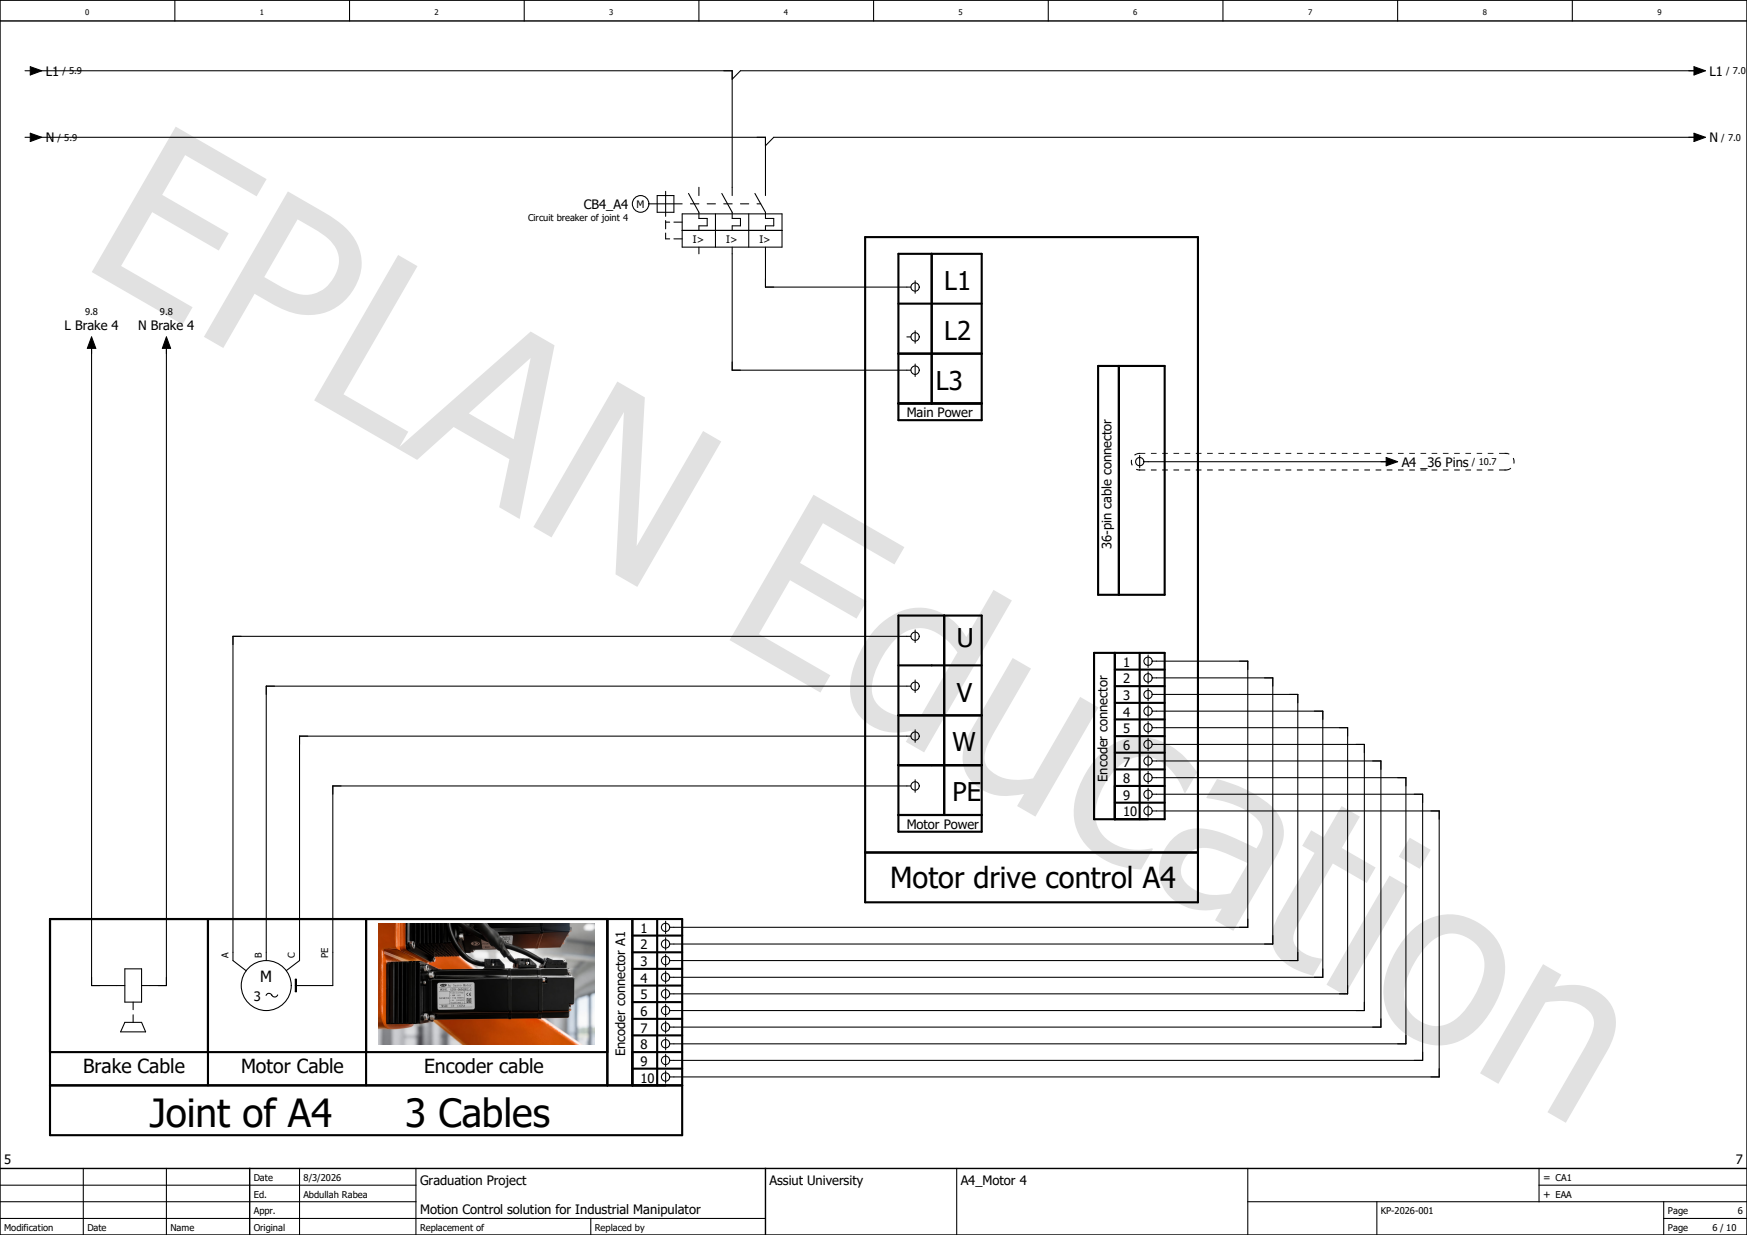
[picture p54: page 6]
A4_Motor 4; Main Power; Encoder connector 36⁻pin cable connector; Joint of A4; 3 Cables; 10 Encoder connector A¹; BCPE M; L Brake 4; N Brake 4; A4 _36 Pins / 10.7

Circuit breaker of joint 4

L2
L3

Motor Power
Motor drive control A4

Brake Cable | Motor Cable | Encoder cable | 9

L1

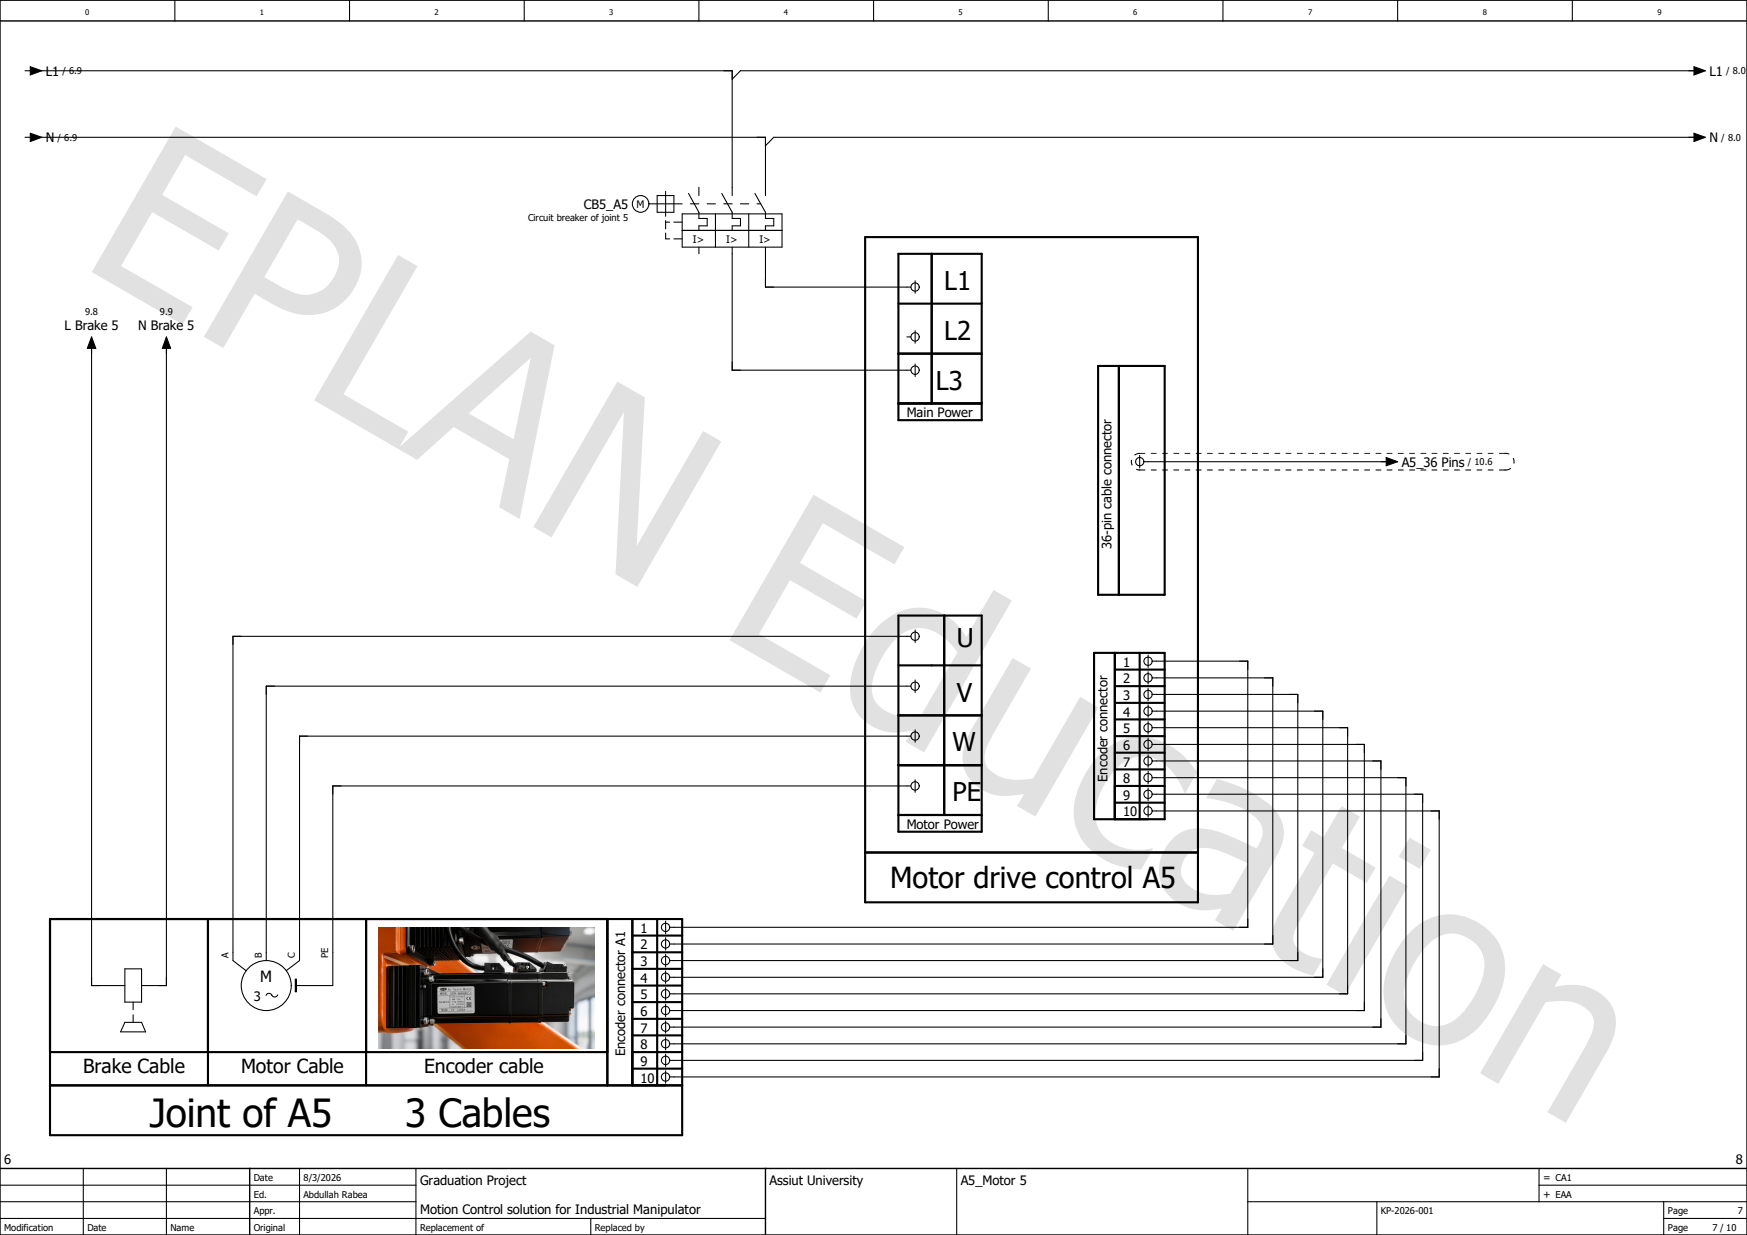
[picture p55: page 7]
A5_Motor 5; Main Power; Encoder connector 36⁻pin cable connector; Joint of A5; 3 Cables; 10 Encoder connector A¹; BCPE M; L Brake 5; N Brake 5; A5_36 Pins / 10.6

Circuit breaker of joint 5

L2
L3

Motor Power
Motor drive control A5

Brake Cable | Motor Cable | Encoder cable | 9

L1

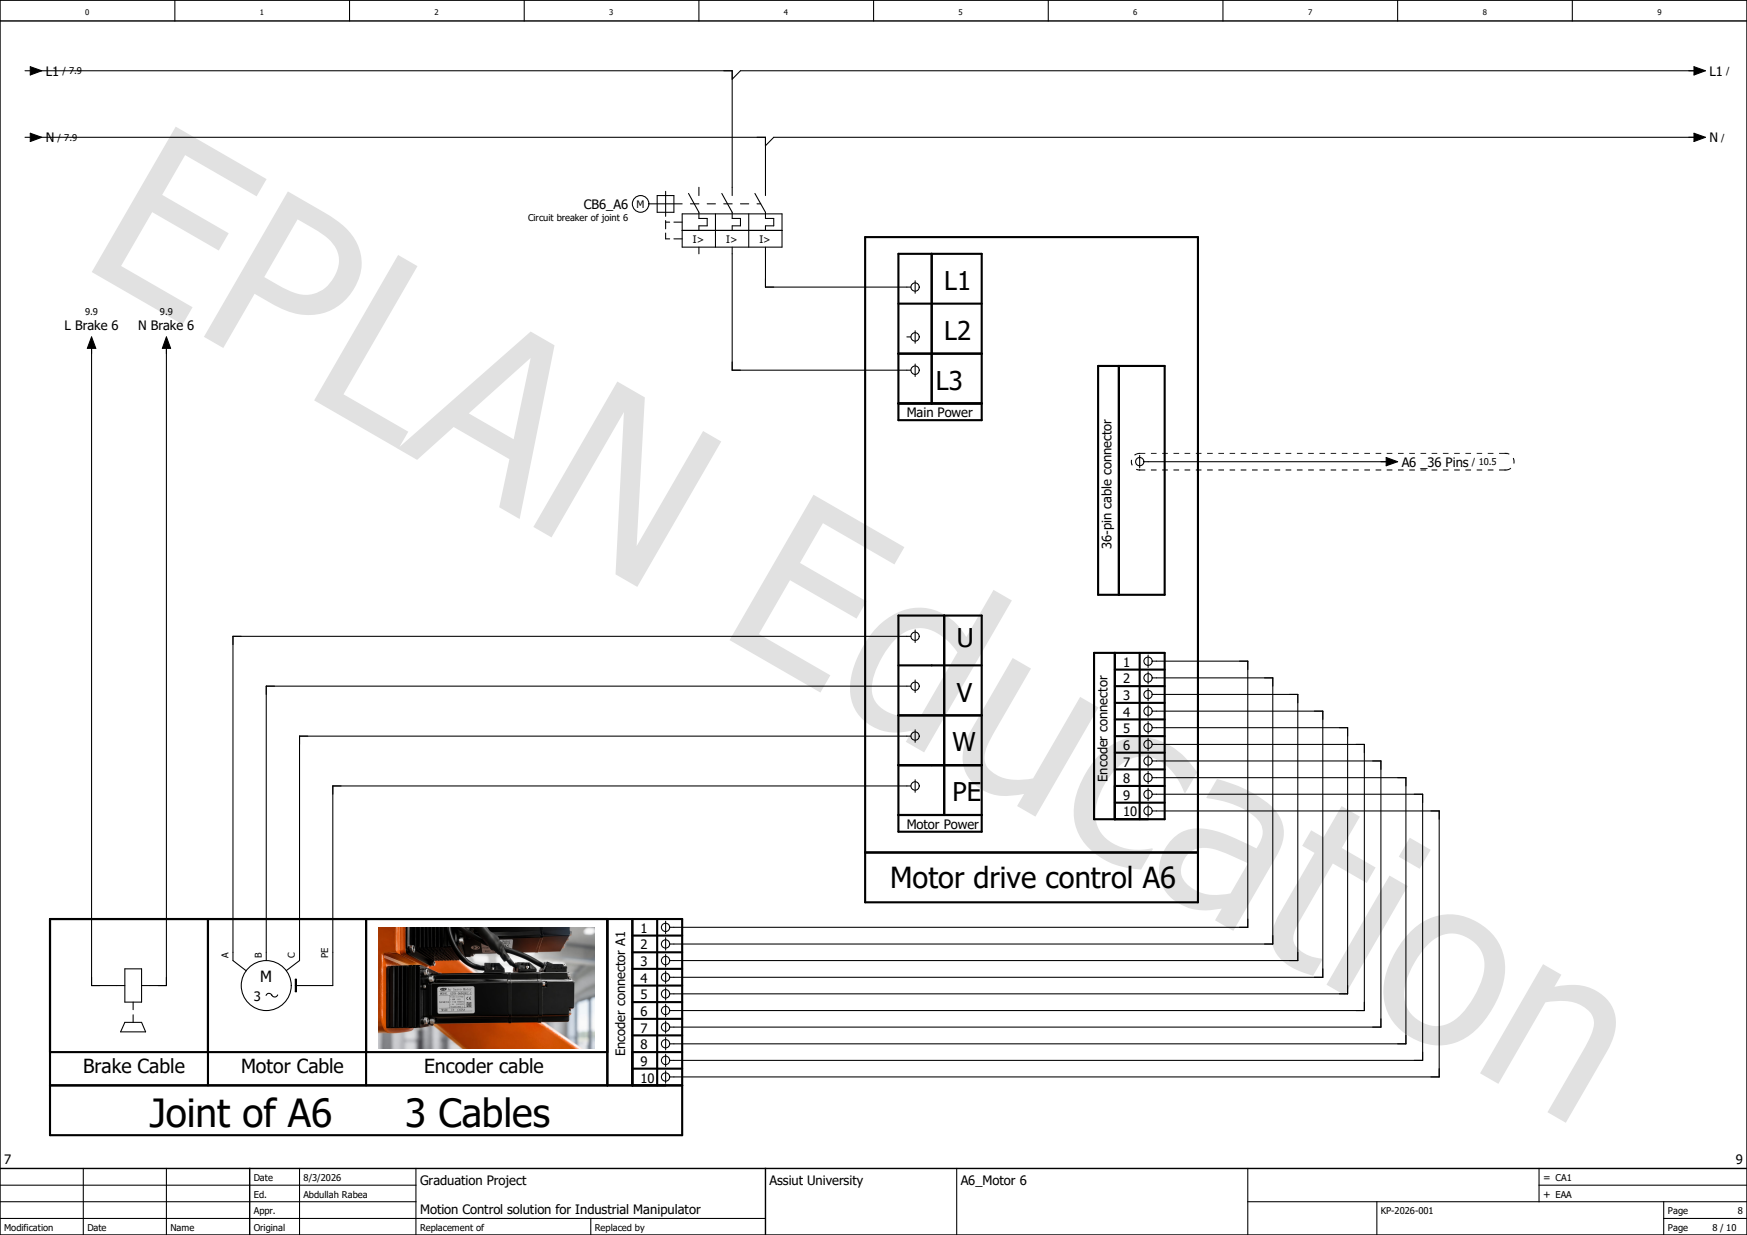
[picture p56: page 8]
A6_Motor 6; Main Power; Encoder connector 36⁻pin cable connector; Joint of A6; 3 Cables; 10 Encoder connector A¹; BCPE M; L Brake 6; N Brake 6; A6 _36 Pins / 10.5

Circuit breaker of joint 6

L2
L3

Motor Power
Motor drive control A6

Brake Cable | Motor Cable | Encoder cable | 9

Power supply 24 volt | L
| N

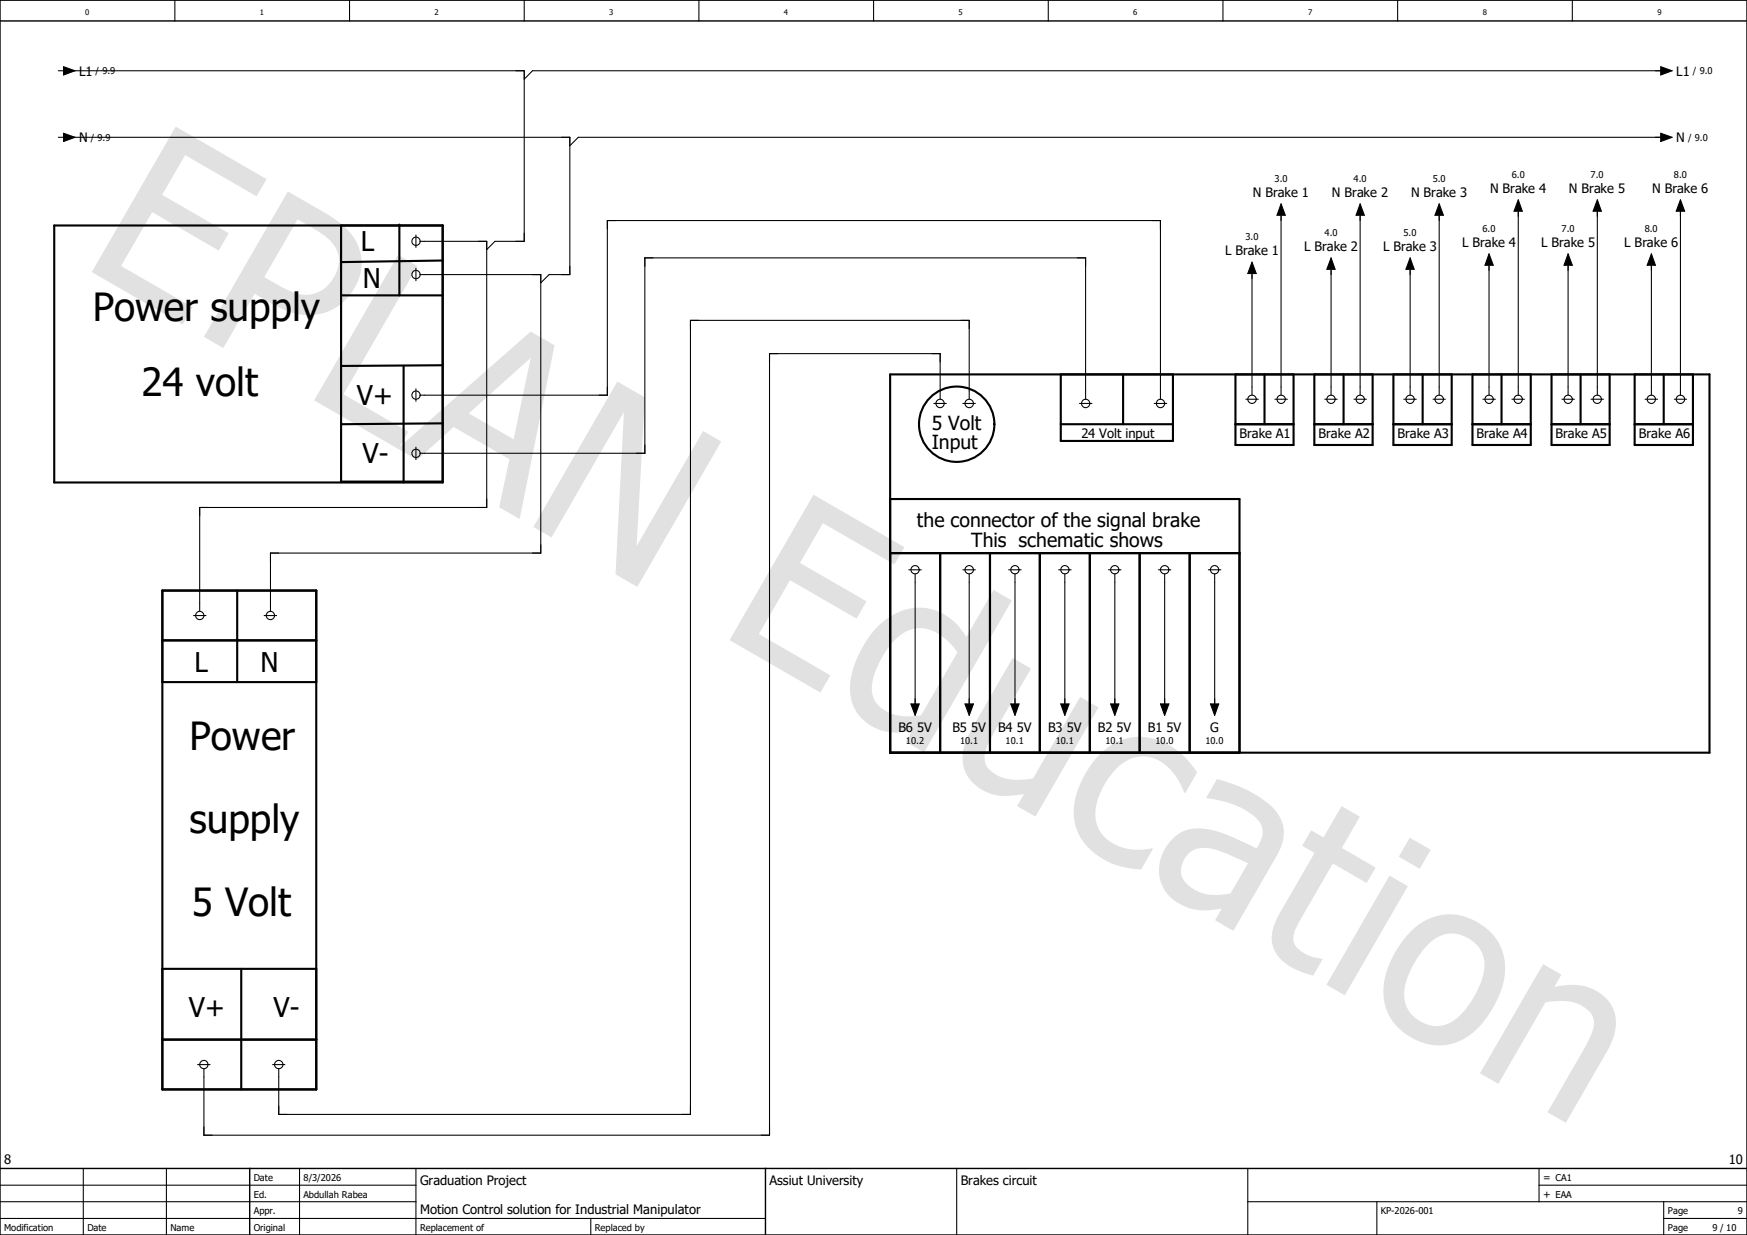
[picture p57: page 9]
Brakes circuit; Power; supply; 5 Volt; 24 Volt input; Brake A1; Brake A2; Brake A3; Brake A4; Brake A5; Brake A6 5 Volt; Input; L Brake 1; N Brake 1; L Brake 2; N Brake 2; L Brake 3; N Brake 3; L Brake 4; N Brake 4; L Brake 5; L Brake 6; N Brake 6; N Brake 5

V+
V-

the connector of the signal brake
This schematic shows

Power supply 12 volt | L
| N

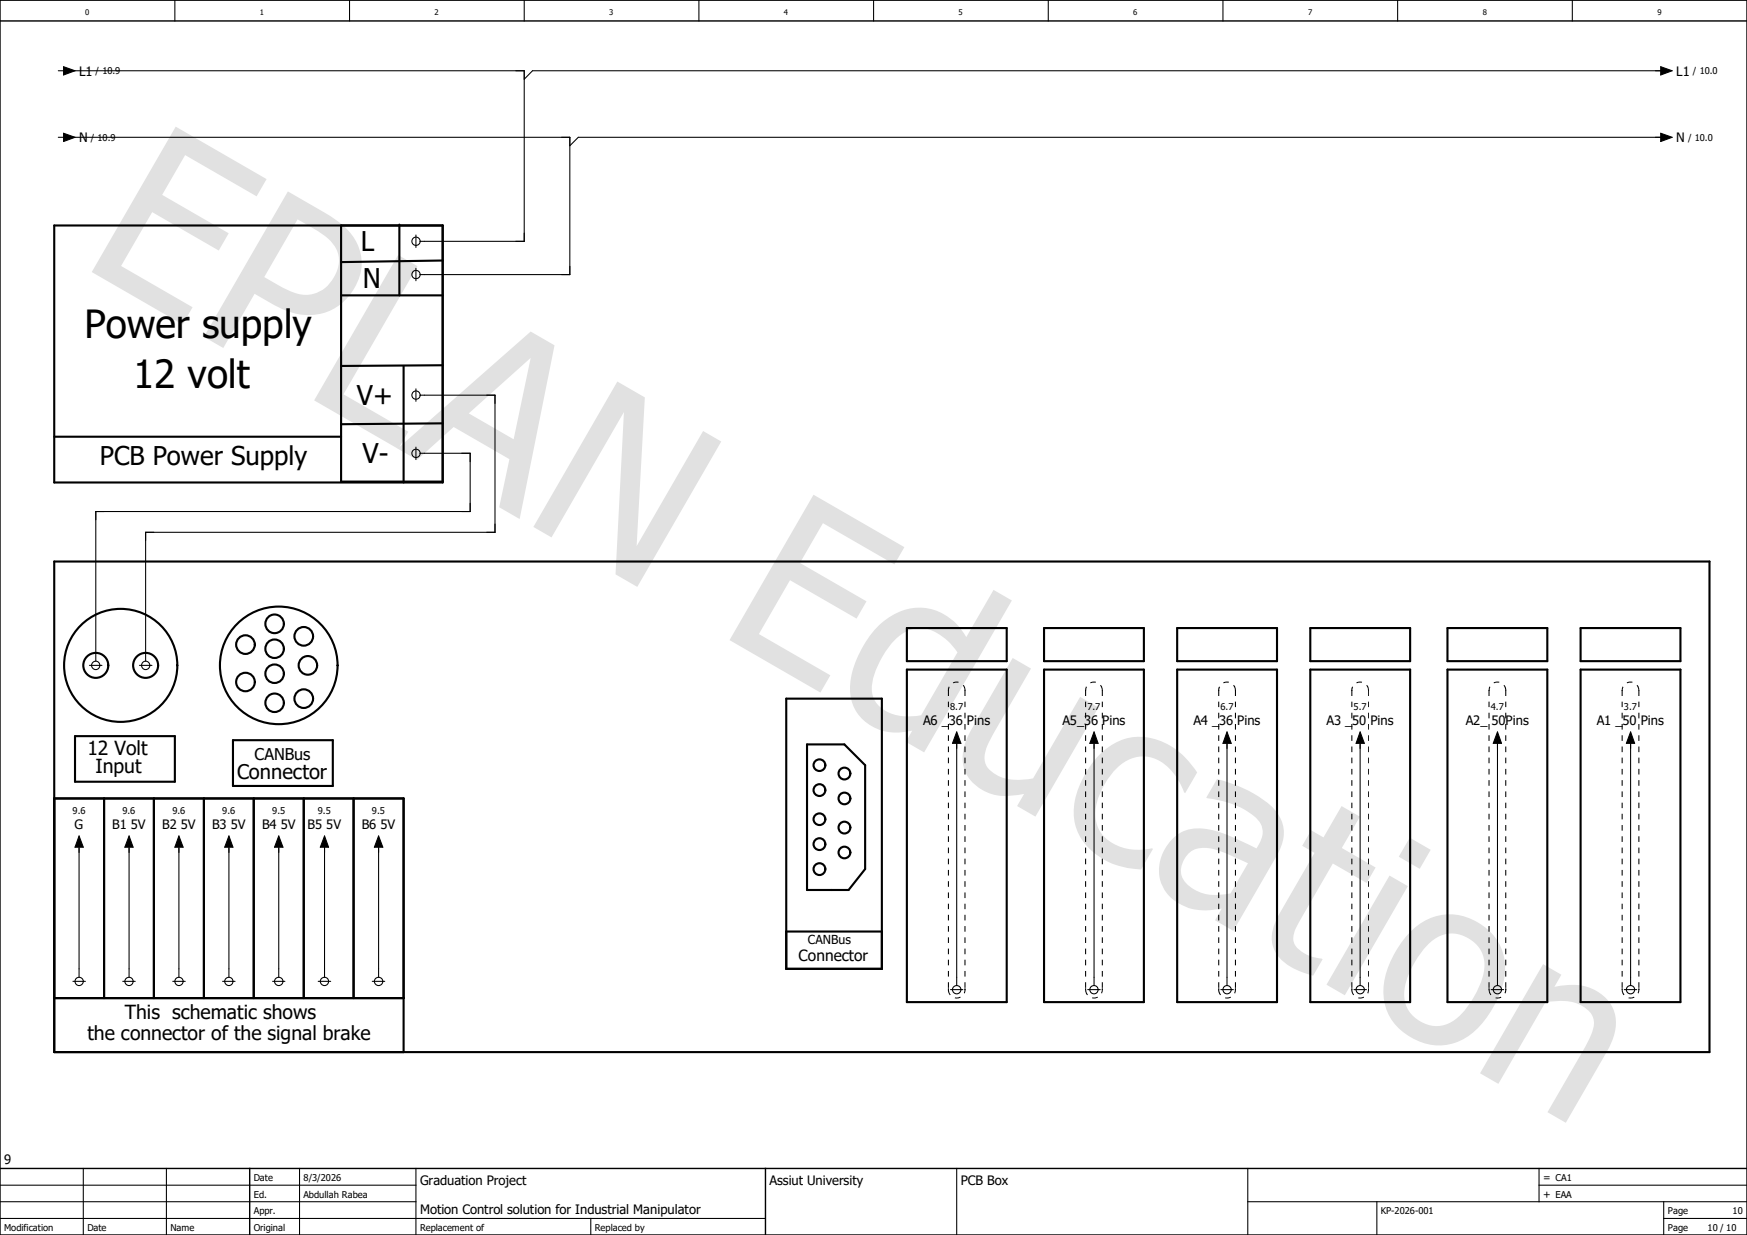
[picture p58: page 10]
PCB Box; 12 Volt Input; CANBus Connector; A1 _50 Pins; A2_ 50Pins; A3 _50 Pins; A4 _36 Pins; A5_36 Pins; A6 _36 Pins

V+
V-

PCB Power Supply

This schematic shows
the connector of the signal brake
