kuka-kr16-l6/Motion-control-solutions-for-an-industrial-manipulator/low_level_control/Core/Inc/main.h

#define brake_Pin LL_GPIO_PIN_2
#define brake_GPIO_Port GPIOE
#define relay_Pin LL_GPIO_PIN_3
#define relay_GPIO_Port GPIOE
#define clear_Pin LL_GPIO_PIN_0
#define clear_GPIO_Port GPIOA
#define dir_Pin LL_GPIO_PIN_1
#define dir_GPIO_Port GPIOA
#define ServoReady_Pin LL_GPIO_PIN_12
#define ServoReady_GPIO_Port GPIOB
#define ServoReady_EXTI_IRQn EXTI15_10_IRQn
#define servo_on_Pin LL_GPIO_PIN_15
#define servo_on_GPIO_Port GPIOD
#define led1_Pin LL_GPIO_PIN_10
#define led1_GPIO_Port GPIOA
#define JOINT_1			1
#define JOINT_2			2
#define JOINT_3			3
#define JOINT_4			4
#define JOINT_5			5
#define JOINT_6			6
#define NODE_SLAVE_ID	JOINT_5
