kuka-kr16-l6/Motion-control-solutions-for-an-industrial-manipulator/(commit log)

2025-05-01 esp32 code commit
2025-05-27 gazebo pkg
    [KR16_L6.xacro, base_link.STL, depot.sdf, link_1.STL, link_2.STL, link_3.STL, link_4.STL, link_5.STL]
2026-01-29 Initial commit: CAN Node1 STM32CubeIDE project
2026-08-04 Enhance future scope section in README
    Expanded future scope with detailed plans for closed-loop control, encoder feedback, and firmware updates.
