kuka-kr16-l6/Motion-control-solutions-for-an-industrial-manipulator/(notices)

Notices in the files:
low_level_control/Core/Inc/main.h:
Copyright (c) 2026 STMicroelectronics.
All rights reserved.
This software is licensed under terms that can be found in the LICENSE file
