kuka-kr16-l6/Motion-control-solutions-for-an-industrial-manipulator/hardware/control_cabinet/panel.jpg

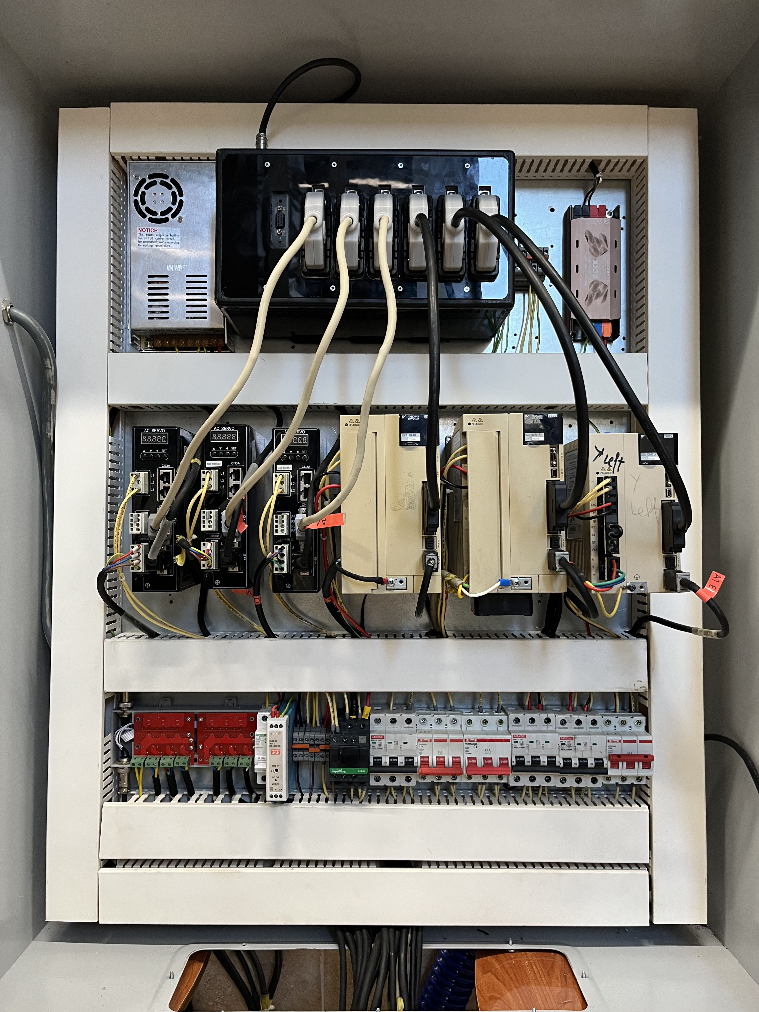
[picture p2: hardware/control_cabinet/panel.jpg]
hardware/control_cabinet/panel.jpg
